AxelAndrews/DocumentationSD/README.md

# DocumentationSD
Documentation hub for the 2024-2025 Portal Box Senior Design project. Contains instruction guides, reports, diagrams, and other documentation related to the project.
