AxelAndrews/DocumentationSD/Diagrams/Other/Work Breakdown Structure.docx

### Work Breakdown Structure

#### 1. Project Management (Axel)

  1.1. Define project scope and requirements
  1.2. Develop and monitor project timeline
  1.3. Coordinate with team members and stakeholders

#### 2. Hardware Design

  2.1. PCB Design & Fabrication (Colton)
    2.1.1. Initial schematic design for ESP32 compatibility
    2.1.2. Layout and routing
    2.1.3. Order PCB fabrication (account for lead time)
  2.2. Enclosure Design (Peter + Aidan)
    2.2.1. Define material and dimensions
    2.2.2. Design for component fitting (PCB, display, RFID module)
    2.2.3. Create a 3D model and prototype (e.g., 3D printing)
  2.3. Power Relay System (Colton)
    2.3.1. Select appropriate relays for 120 VAC switching and USB interlock
    2.3.2. Design wiring for safety and functionality
    2.3.3. Test relay and interlock function with dummy loads
3. Firmware Development
  3.1. ESP32 Firmware Migration (Kevin)
    3.1.1. Analyze and adapt existing Raspberry Pi firmware functions
    3.1.2. Develop ESP32-compatible code for RFID, relays, and LED feedback
    3.1.3. Set up development environment for testing
  3.2. Functional Modules
    3.2.1. RFID Module Integration (Aidan)
      3.2.1.1. Program RFID handling for access control
      3.2.1.2. Test RFID responses with user cards
      3.2.1.3. Improve RFID training flow
    3.2.2. Display & Buttons (Aidan + Peter)
      3.2.2.1. Decide on display type and function
      3.2.2.2. Implement LED and buzzer integration
      3.2.2.3. Develop user interaction logic
    3.2.3. Current Sense IC (Colton)
      3.2.3.1. Integrate current-sensing IC into ESP32
      3.2.3.2. Develop code to monitor and report power output levels
4. Front-End Development
  4.1. Admin Dashboard (Aidan/Kevin/Axel)
    4.1.1. Extract current data and create representations
    4.1.2. Determine additional data to transmit/collect
    4.1.3. Add to Makerportal
  4.2. User Dashboard (Aidan/Kevin/Axel)
    4.2.1. Determine what can be shown
    4.2.2. Extract data and create representations
    4.2.3. Add to Makerportal
  4.3. General Navigation (Aidan/Kevin/Axel)
    4.3.1. Add Nav-Bar
    4.3.2. Get more user feedback
    4.3.3. Add customizable features (sounds, displays, profiles)

#### 5. System Integration & Testing (James)

  5.1. Component Integration (PCB, relays, RFID, display)
  5.2. Firmware and Hardware Testing
    5.2.1. Unit testing for each module (e.g., RFID, display)
    5.2.2. Integration testing with connected components
  5.3. Prototype Assembly and Functional Testing
    5.3.1. Assemble enclosure with internal components
    5.3.2. Run full-system tests for access, power control, and status reporting

Week 1 Milestone (11/13-11/20): PCB initial design review, Enclosure design 3D model, ESP32 environment setup, RFID prototype reading.

Week 2 Milestone (11/21-12/2): PCB sent for fabrication, power relay and interlock wiring draft, firmware for basic functions, RFID test integration.

Week 3 Milestone (12/2-12/9): Begin hardware integration testing, firmware debugging with components, and full-system trial assembly.
