AxelAndrews/DocumentationSD/Diagrams/Flow Diagrams/FlowDiagramV3.pdf

# Does the machine have a usage charge? Does the User have a positive balance?

Turn on equipment power | Was the card removed? | Box in RunningNoCard State Did the equipment exceeds its timeout? Box stays in previous State

No

No

Yes

Box in RunningTimeout State

Yes

Inserts same RFID card

Presses Button

Inserts Proxy card | Box in RunningProxyCard State Was Authorized user a trainer or administrator?

Inserts Unauth card

Inserts unknown card

Box exceeds grace period time

No | Box in RunningTrainingCard State
Yes Was the card removed? | Sends to database indicating authorized use of equipment has ended for user

Yes

Box in RunningAuthUser State

Did user reinsert previous card and push button?

No

Box Returns to Previous State

Yes Box in IdleAuthCard State

Turn Off

Equipment Power Sends to database indicating authorized use of equipment has ended for user Waits until Card is removed

No

Sends to database

indicating unauthorized user of tried to use machine

Sends to database
indicating authorized use of equipment has begun | Restart equipment timeout timer | Turn on equipment power
Yes | Box in RunningAuthUser State

Yes

No | Sends to database indicating authorized use of equipment has begun for user | Restart equipment timeout timer Box in IdleNoCard State | User Inserts RFID card

## and gives PIN

Is user Authorized?

Is user Active?
Yes | Yes Box in IdleUnauthCard State

No

No | No

Turn Off

Equipment Power Sends to database indicating authorized use of equipment has ended for user

Ovals are actions | Dashed border signifies delay Blue Rectangles are Box States (From FSM) Decision or conditional check
Green is database | Red is power | Dark blue is user actions | Black is box action

# Legend
