AxelAndrews/DocumentationSD/Reports/Spring Semester/Spring Team Orginization and Management Report.docx

# Portal Box Team Organization and Management Report

Project Manager: Axel Andrews

Systems & Performance Engineer: James Powick

Design Engineers: Peter Beaudette, Kevin Duong, Aidan Flynn, Colton Jiorle

The spring semester of senior design started off in the middle of phase 4A. While getting back in the swing of things, we began preparing for our unit tests. Each DE had their respective functions for testing and datasheets to write.
