AxelAndrews/DocumentationSD/Diagrams/Other/WBS V2.docx

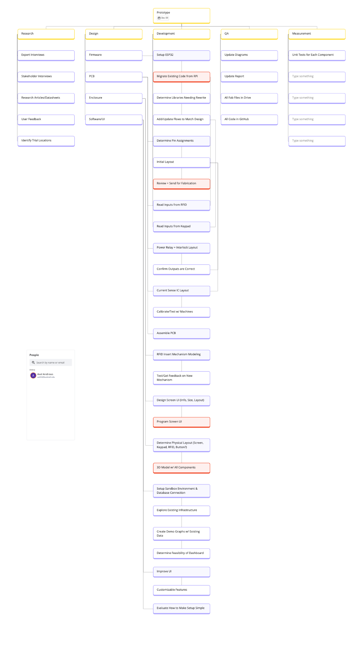
[picture p24: figure]
