AxelAndrews/DocumentationSD/Diagrams/System Maps/SystemMapV1.pdf

System Map (Version 1)

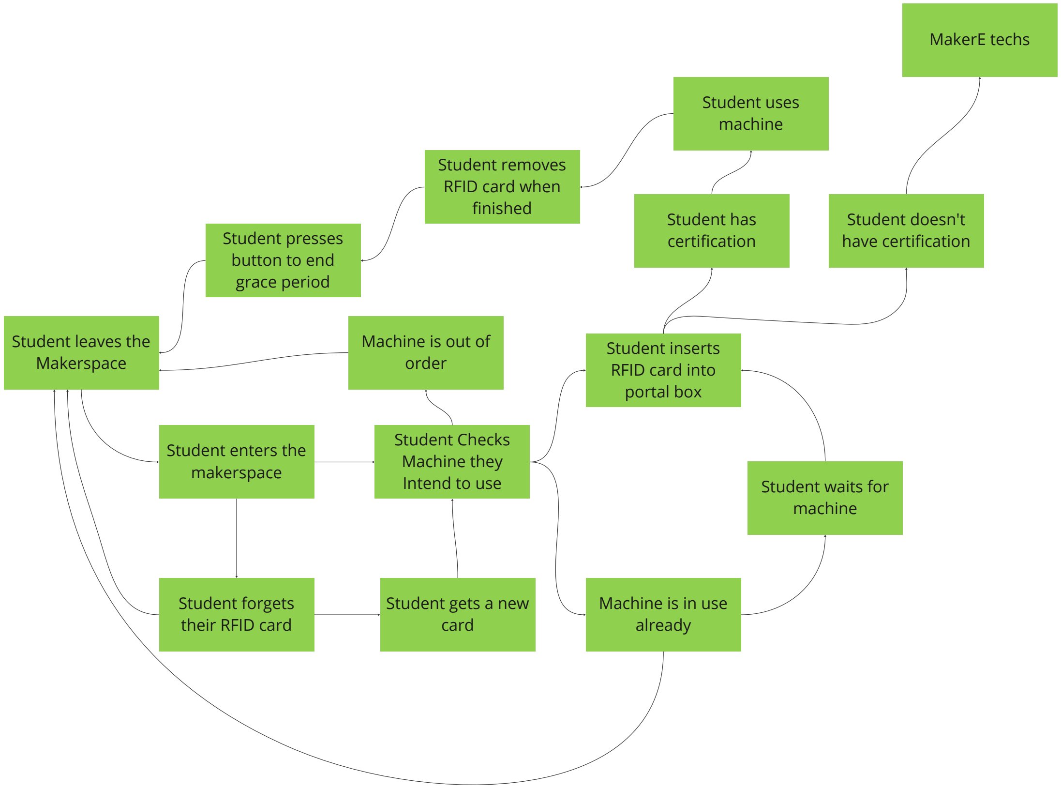
[picture p25: figure]
Student removes RFID card when finished; Machine is out of order; Student presses button to end grace period; Student has certification; Student enters the makerspace; Student leaves the Makerspace; Student waits for machine; Student forgets their RFID card; Student gets a new card; Student inserts RFID card into portal box; Machine is in use already; Student Checks Machine they Intend to use; Student uses machine; Student doesn't have certification; MakerE techs
