AxelAndrews/DocumentationSD/Diagrams/Block Diagrams/L2-V2.pdf

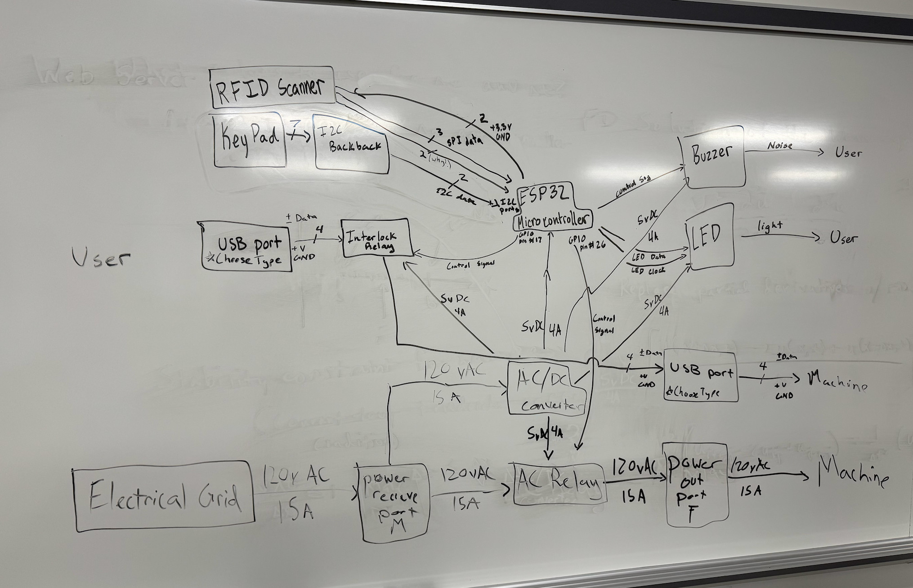
[picture p26: page 1]
