AxelAndrews/DocumentationSD/Fabrication Files/Enclosure/lid_button.SLDPRT

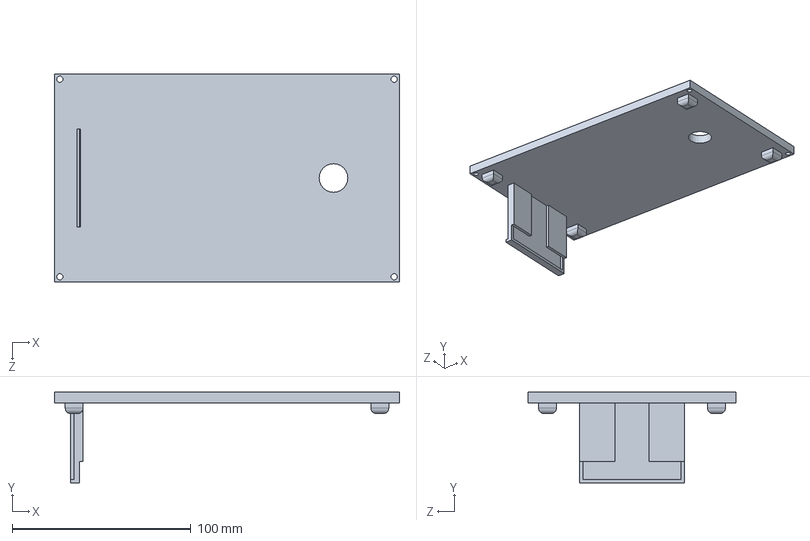
[picture p27: CAD file, 2025-05-12]
Fabrication Files/Enclosure/lid_button.SLDPRT
193.0 x 50.8 x 116.5 mm
