AxelAndrews/DocumentationSD/Fabrication Files/Enclosure/lid_screen_button.SLDPRT

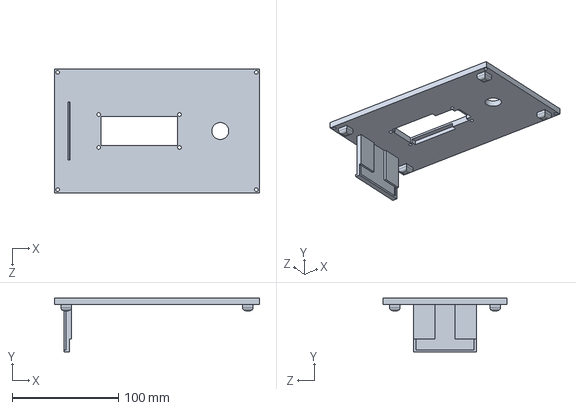
[picture p28: CAD file, 2025-05-12]
Fabrication Files/Enclosure/lid_screen_button.SLDPRT
193.0 x 50.8 x 116.5 mm
