AxelAndrews/DocumentationSD/Fabrication Files/Enclosure/box.SLDPRT

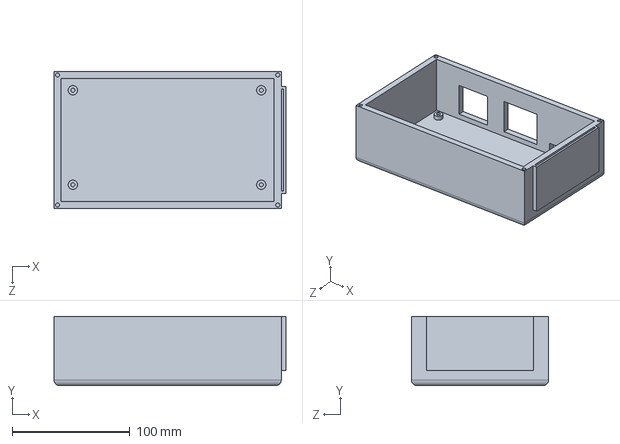
[picture p29: CAD file, 2025-05-12]
Fabrication Files/Enclosure/box.SLDPRT
197.0 x 59.0 x 116.5 mm
