AxelAndrews/DocumentationSD/Fabrication Files/Enclosure/lid.SLDPRT

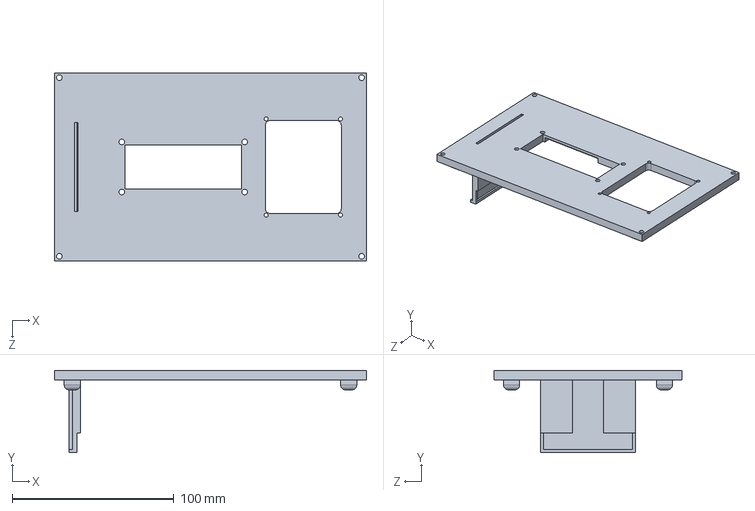
[picture p30: CAD file, 2025-05-12]
Fabrication Files/Enclosure/lid.SLDPRT
193.0 x 50.8 x 116.5 mm
