AxelAndrews/DocumentationSD/Diagrams/Design Abstraction Stacks/DesignAbstractionStackL2.pdf

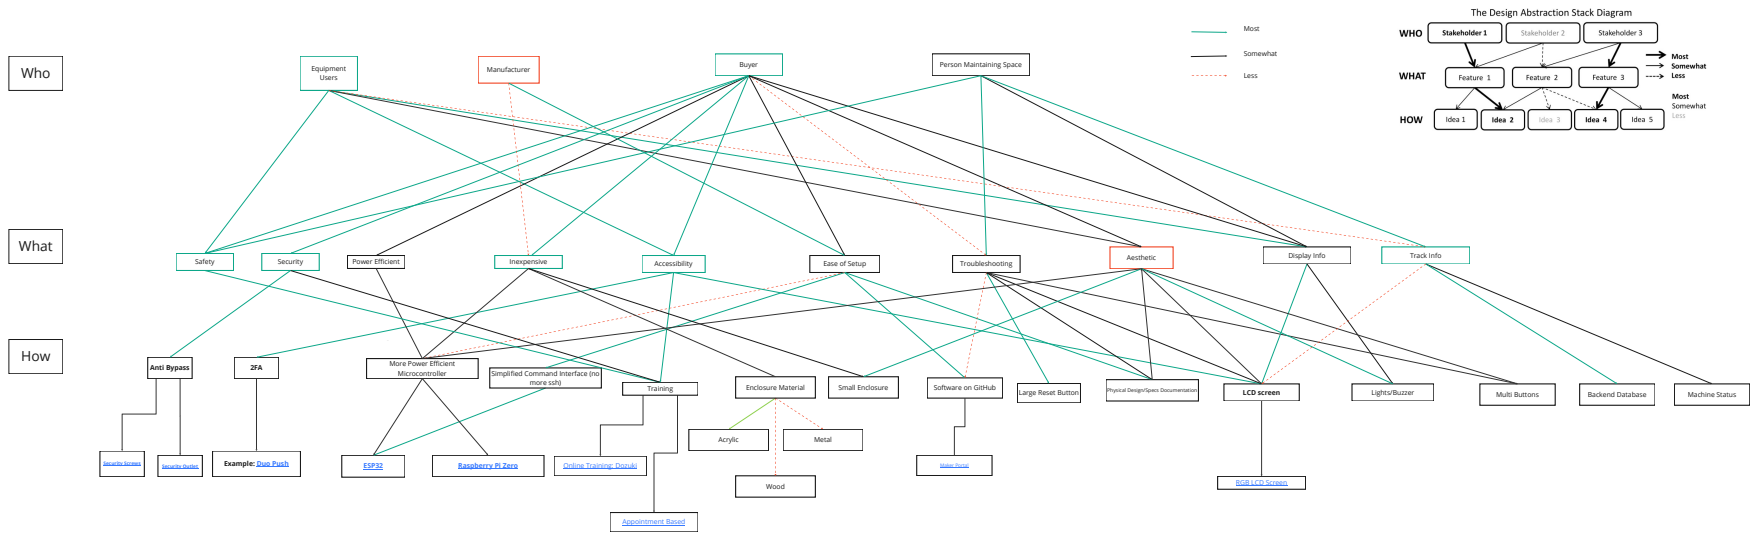
[picture p54: page 1]
ESP32; Wood Acrylic; Metal Raspberry Pi Zero; Online Training: Dozuki; Maker Portal Security Screws; Large Reset Button; Multi Buttons; Backend Database; Machine Status; Security Outlet; Example: Duo Push; Simplified Command Interface (no more ssh); Training; Enclosure Material; Small Enclosure How; Anti Bypass; Physical Design/Specs Documentation; LCD screen; more effi 2FA; More Power Efficient Microcontroller; Lights/Buzzer Software on GitHub Accessibility; Ease of Setup; Troubleshooting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

Less Person Maintaining Space Who

RGB LCD Screen (https://www.adafruit.com/product/398) Appointment Based
