AxelAndrews/DocumentationSD/Diagrams/Block Diagrams/L0-V1.pdf

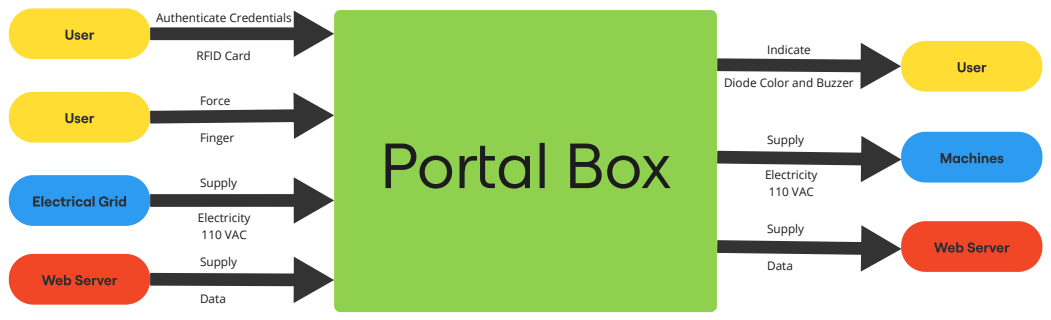
[picture p55: page 1]
Authenticate Credentials; RFID Card; Finger; Force; Electricity 110 VAC; Supply; Data; Indicate

Diode Color and Buzzer
