AxelAndrews/DocumentationSD/Diagrams/Block Diagrams/L1-V2.pdf

# Portal Box Block Diagram L1

# Acrylic Enclosure

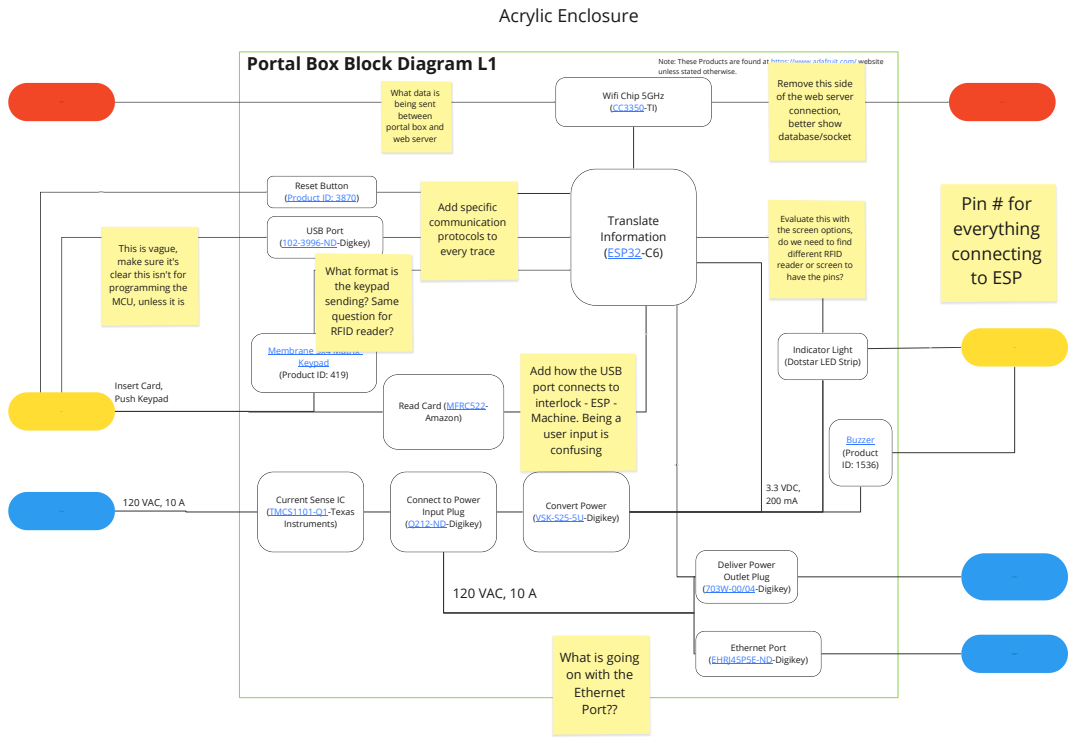
[picture p56: page 1]
User; Electrical Grid; Convert Power (VSK-S25-5U-Digikey); Translate Information (ESP32-C6); Binary 0 or 1; Web Server; 120 VAC, 10 A; Insert Card, Push Keypad; 3.3 VDC, 200 mA; Buzzer (Product ID: 1536); Membrane 3x4 Matrix Keypad (Product ID: 419); Wifi Chip 5GHz (CC3350-TI); Web Server Data; User/Machine Data; Ethernet Port (EHRJ45P5E-ND-Digikey); Deliver Power Outlet Plug (703W-00/04-Digikey); Reset Button (Product ID: 3870); Push Button; Binary 0 or 1 USB Port; (102-3996-ND-Digkey)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

Note: These Products are found at https://www.adafruit.com/ website
unless stated otherwise.

Remove this side
of the web server
connection,
better show
database/socket

What data is
being sent
between
portal box and
web server

Web Server 2.4 or 5GHz

Evaluate this with
the screen options,
do we need to find
different RFID
reader or screen to
have the pins?

User Inputs Keypresses
This is vague,
make sure it's
clear this isn't for
programming the
MCU, unless it is

What format is
the keypad
sending? Same
question for
RFID reader?

Send Binary to
ESP32

User Card Data

Indicator Light
(Dotstar LED Strip)

Add how the USB
port connects to
interlock - ESP -
Machine. Being a
user input is
confusing

Read Card (MFRC522- (https://www.amazon.com/SunFounder-Mifare-Reader-Arduino-Raspberry/dp/B07KGBJ9VG) Amazon)

Signal To Deliver Power to Machines

Current Sense IC
(TMCS1101-Q1-Texas (https://www.ti.com/product/TMCS1101-Q1?ds_k=TMCS1101-Q1&DCM=yes&gad_source=1&gclsrc=aw.ds)
Instruments)

Connect to Power
Input Plug
(Q212-ND-Digikey) (https://www.digikey.com/en/products/detail/qualtek/703W-00-04/245553)

Machines
(Able to be turned off)

What is going
on with the
Ethernet
Port??

Constantly Powered Machines
