AxelAndrews/DocumentationSD/Diagrams/Block Diagrams/L2-V6.pdf

# User

# Buzzer

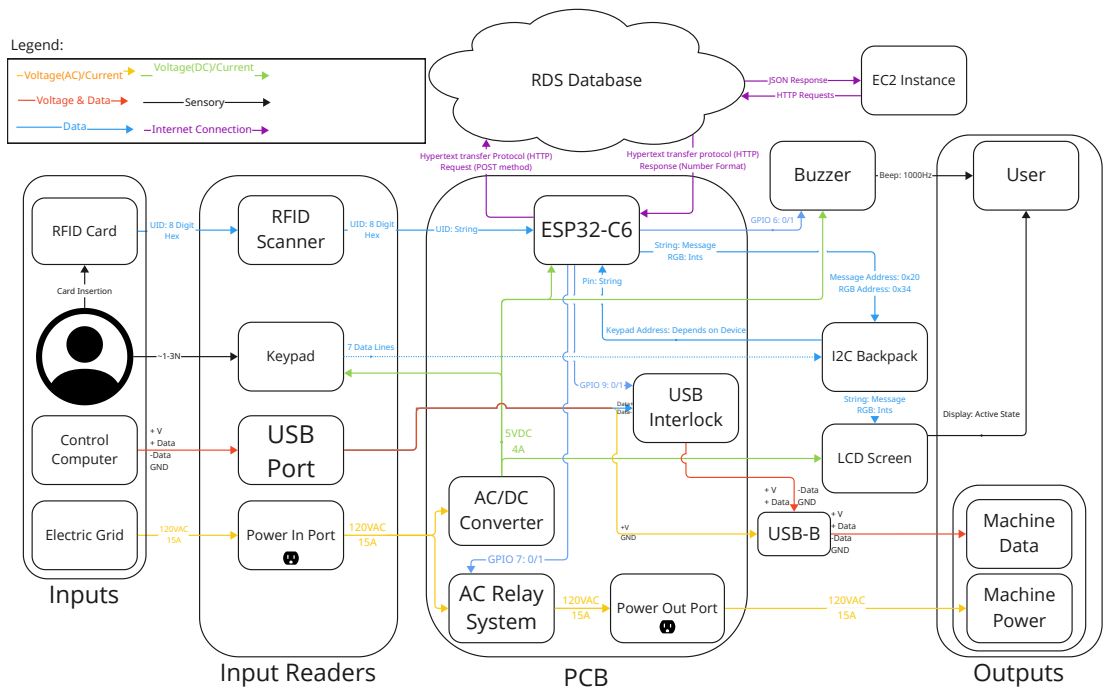
[picture p57: page 1]
ESP32-C6 RFID Scanner; USB Port; Machine Power; Machine Data; AC Relay System; AC/DC Converter; Input Readers; RFID Card; UID: 8 Digit; Hex; LCD Screen; I2C Backpack; PCB; GPIO 6: 0/1; Beep: 1000Hz; 120VAC 15A; UID: 8 Digit Hex; UID: String; 5VDC 4A; Message Address: 0x20 RGB Address: 0x34; String: Message RGB: Ints; Keypad; 7 Data Lines; Pin: String; Outputs; Electric Grid; 120VAC; Card Insertion; Inputs; USB Interlock; GPIO 9: 0/1; USB-B; + V + Data -Data GND; Control Computer; +V GND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

Voltage(DC)/Current

Voltage(AC)/Current
Voltage & Data
Data

Hypertext transfer Protocol (HTTP)
Request (POST method)

Hypertext transfer protocol (HTTP)
Response (Number Format)

Keypad Address: Depends on Device

Display: Active State

Power In Port

120VAC
Power Out Port
