AxelAndrews/DocumentationSD/Diagrams/Use Case Diagrams/UseCaseV2-1.pdf

# Portal Box Use Cases

Scan Card | Standard Users

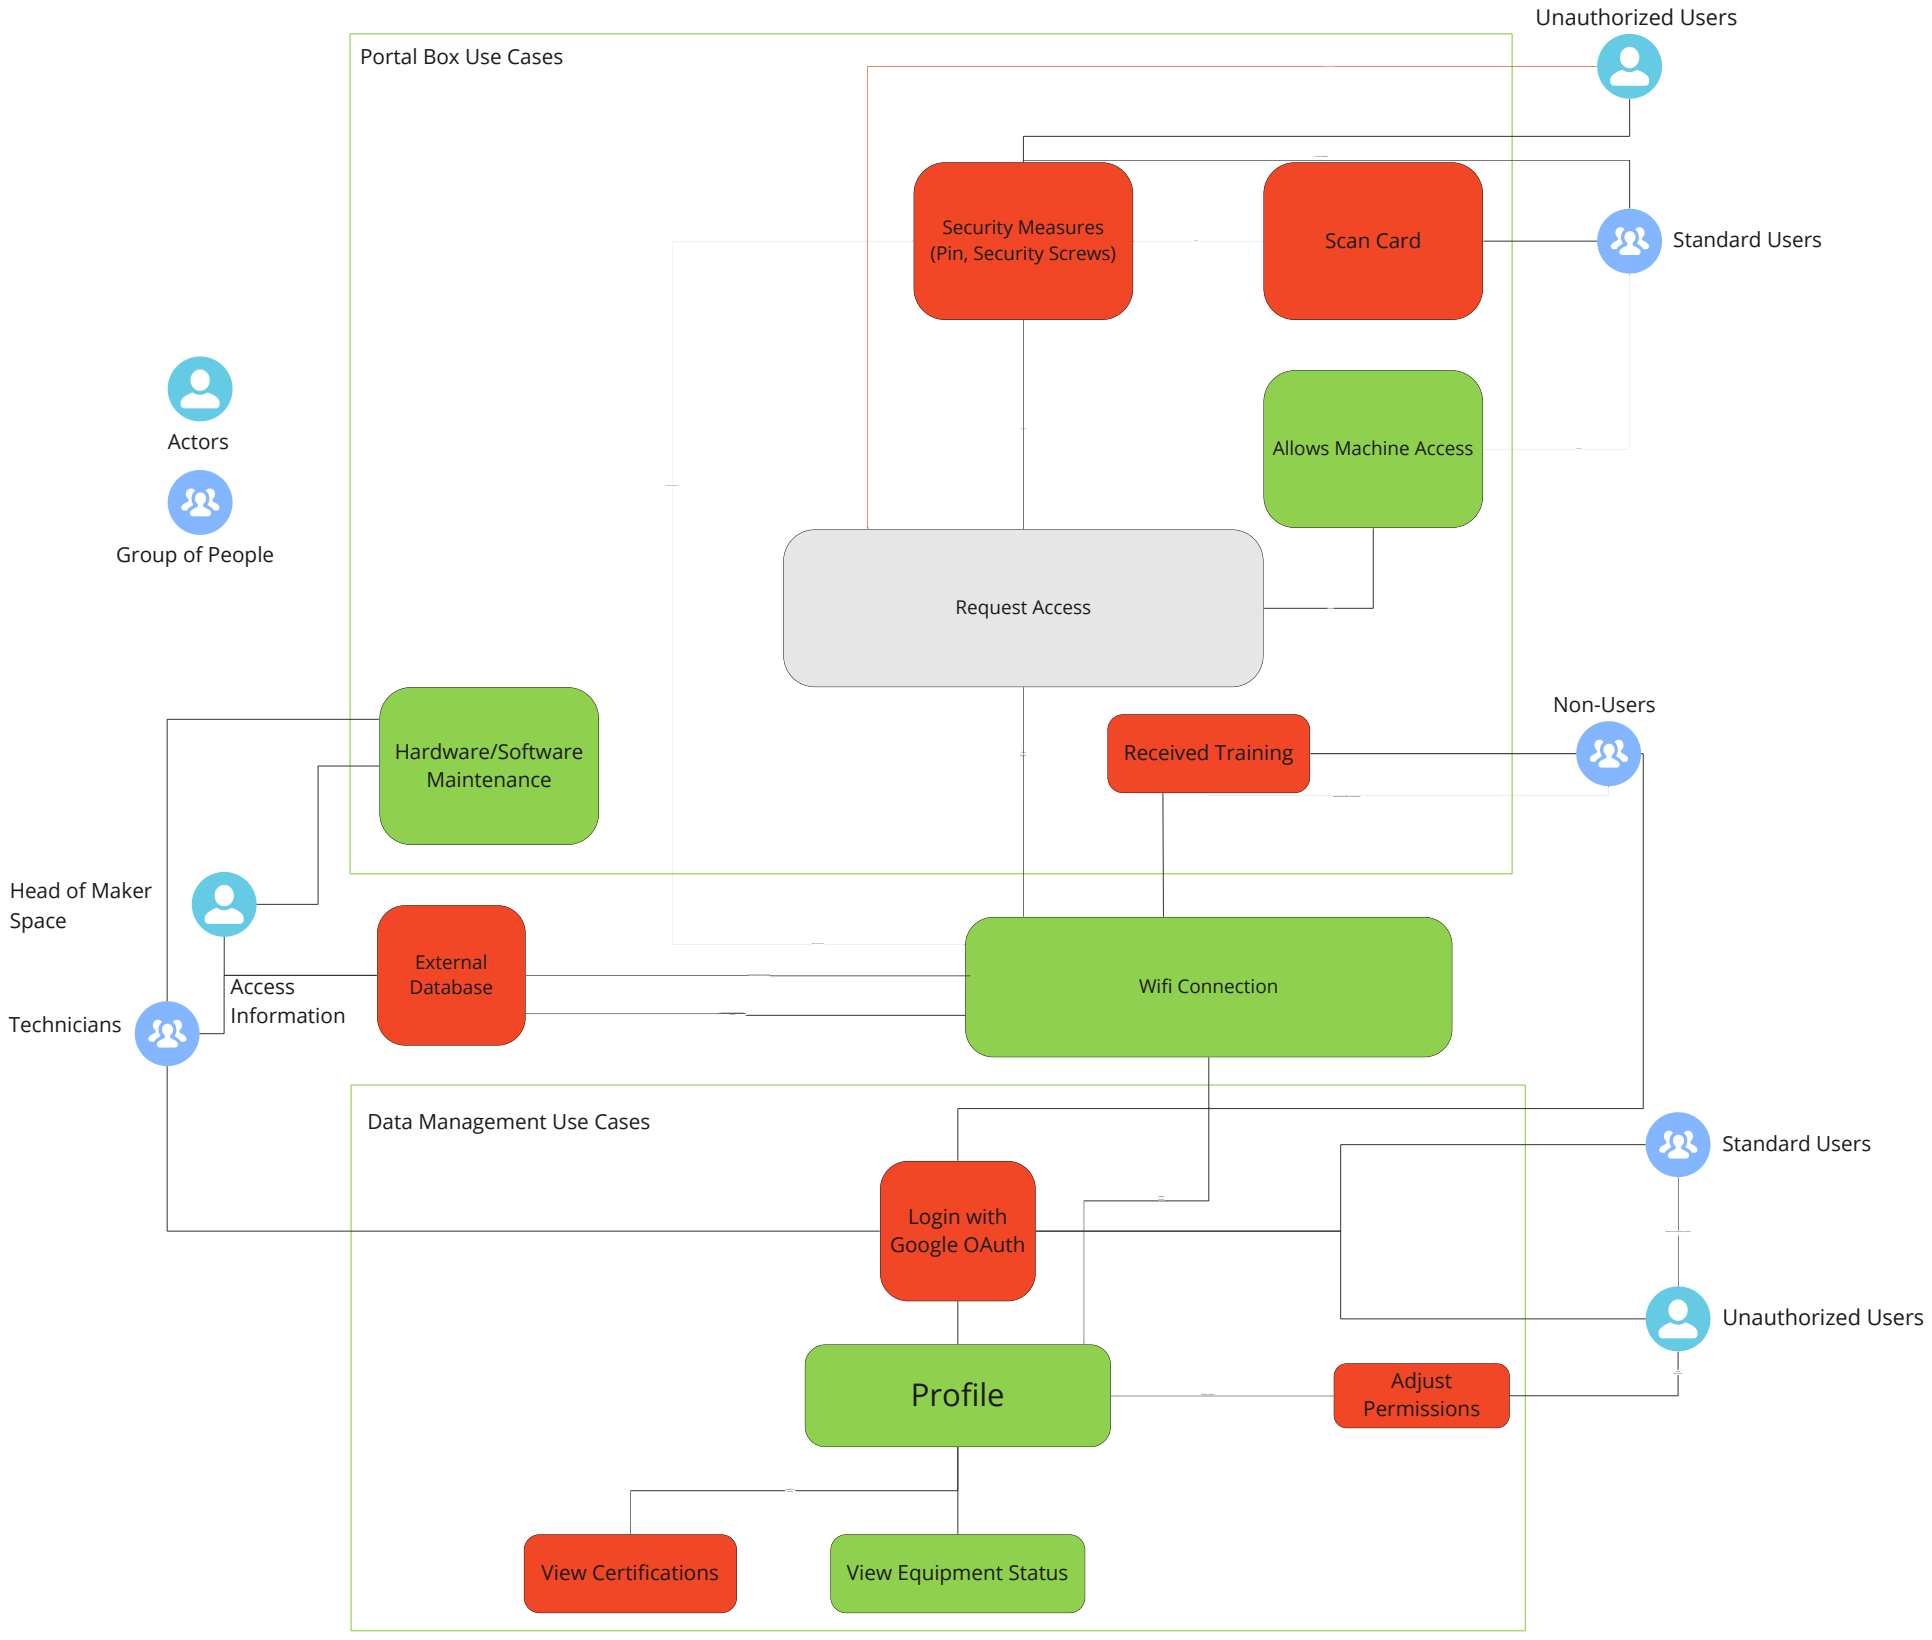
[picture p58: page 1]
Hardware/Software Maintenance; Technicians; Request Access; Wifi Connection; Actors; Allows Machine Access; Use Machine; Include; Unauthorized Users; Confirm Identity; Confirm Information; Extend; Deny Access; Non-Users; Received Training; Standard Users; View Certifications; Adjust Permissions Profile; Available to all users; Update Profile; Login with Google OAuth; External Database; Access Information; Grant Permission; Send Request

Security Measures
(Pin, Security Screws)

Extend, if Pin

Group of People

Receive Permission (if Successful)

Head of Maker
Space

Take User Information from Database

Microcontroller sends information to Database

Data Management Use Cases

Extend; If successfully certified

Extend; if Admin

View Equipment Status
