AxelAndrews/DocumentationSD/Diagrams/Use Case Diagrams/UseCaseV2-3.pdf

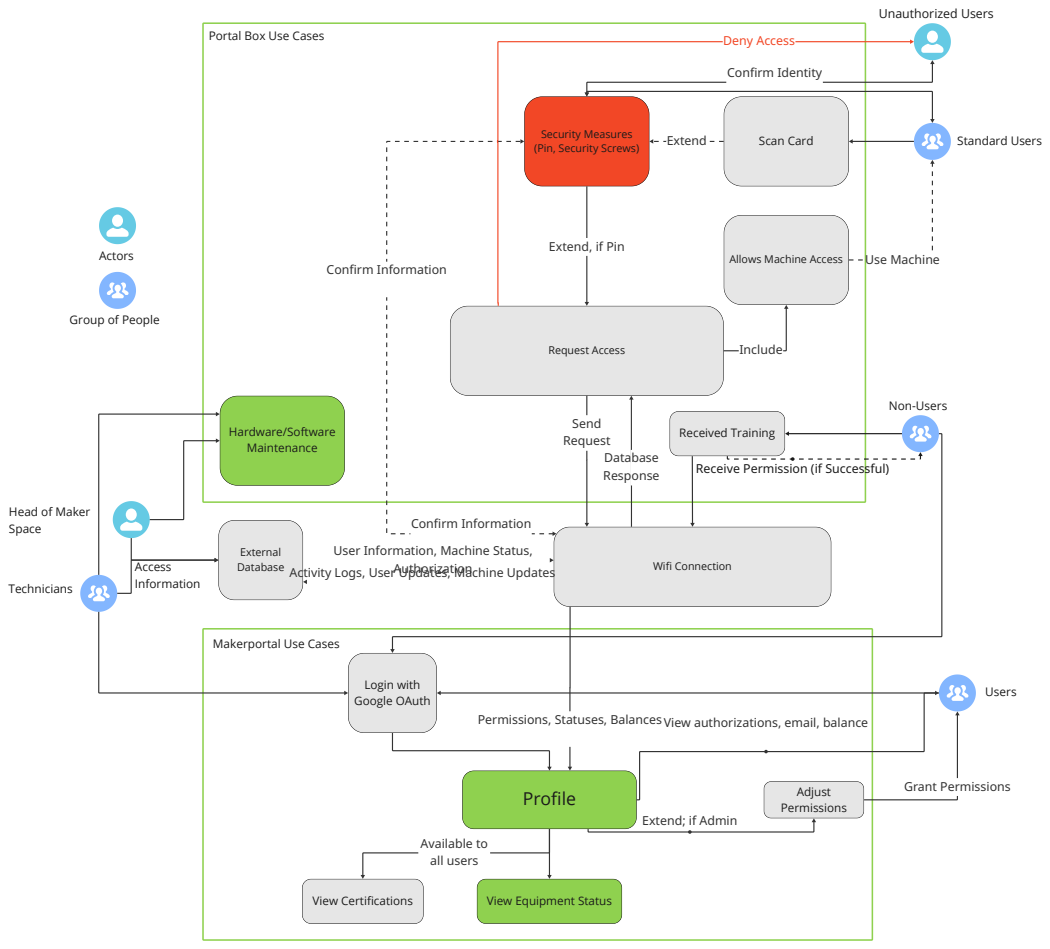
[picture p59: page 1]
Scan Card; Standard Users; Hardware/Software Maintenance; Technicians; Request Access; Wifi Connection; Actors; Allows Machine Access; Use Machine; Include; Unauthorized Users; Confirm Identity; Confirm Information; Extend; Deny Access; Non-Users; Received Training; Users; View Certifications; Adjust Permissions Profile; Available to all users; Login with Google OAuth; Access; Authorization; Information; Grant Permissions; Send Request Database Response

Portal Box Use Cases

Security Measures
(Pin, Security Screws)

Extend, if Pin

Group of People

Receive Permission (if Successful)

Head of Maker
Space

User Information, Machine Status,

External
Database Activity Logs, User Updates, Machine Updates

Makerportal Use Cases

Permissions, Statuses, BalancesView authorizations, email, balance

Extend; if Admin

View Equipment Status
