AxelAndrews/DocumentationSD/Diagrams/Flow Diagrams/MakerportalFlowDiagram.pdf

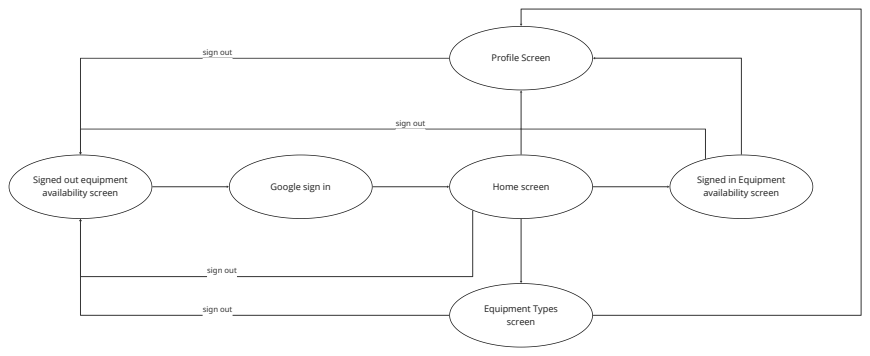
[picture p60: page 1]
availability screen; Google sign in; Home screen; Equipment Types screen; Profile Screen; sign out

Signed out equipment

Signed in Equipment
availability screen
