AxelAndrews/DocumentationSD/Diagrams/System Maps/Community&UserValueLoop.pdf

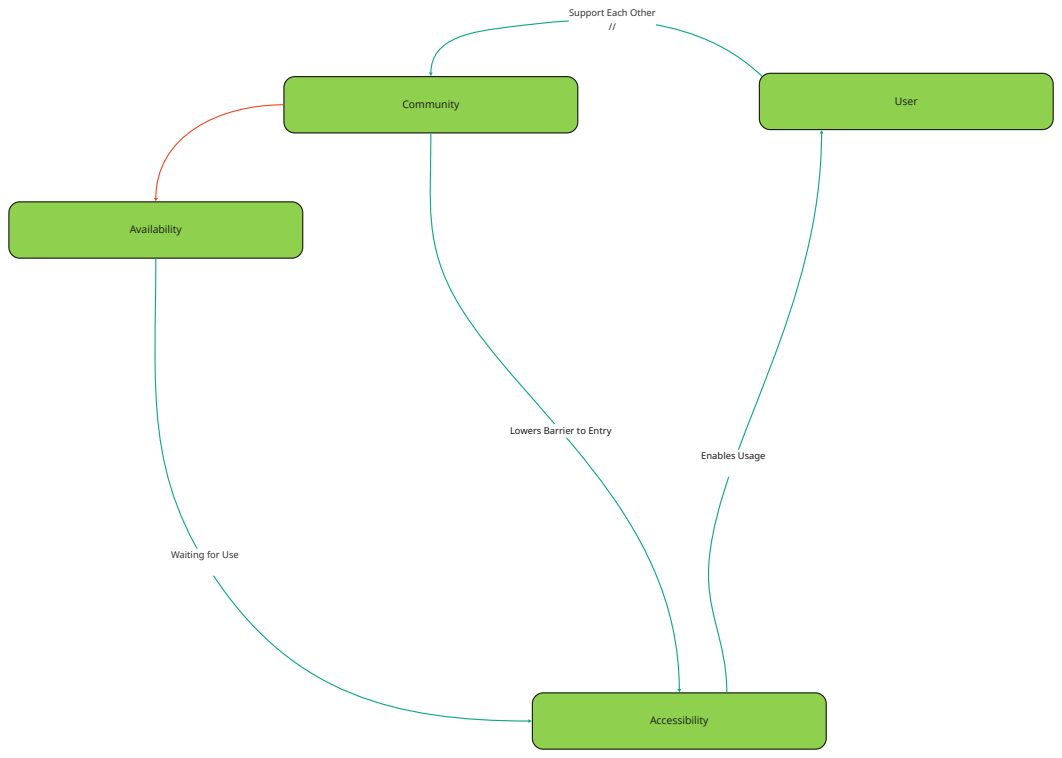
[picture p61: page 1]
Accessibility; User; Enables Usage; Community; Availability

Support Each Other

Lowers Barrier to Entry

Waiting for Use
