AxelAndrews/DocumentationSD/Diagrams/System Maps/DirectorValueLoop.pdf

## Director of Space

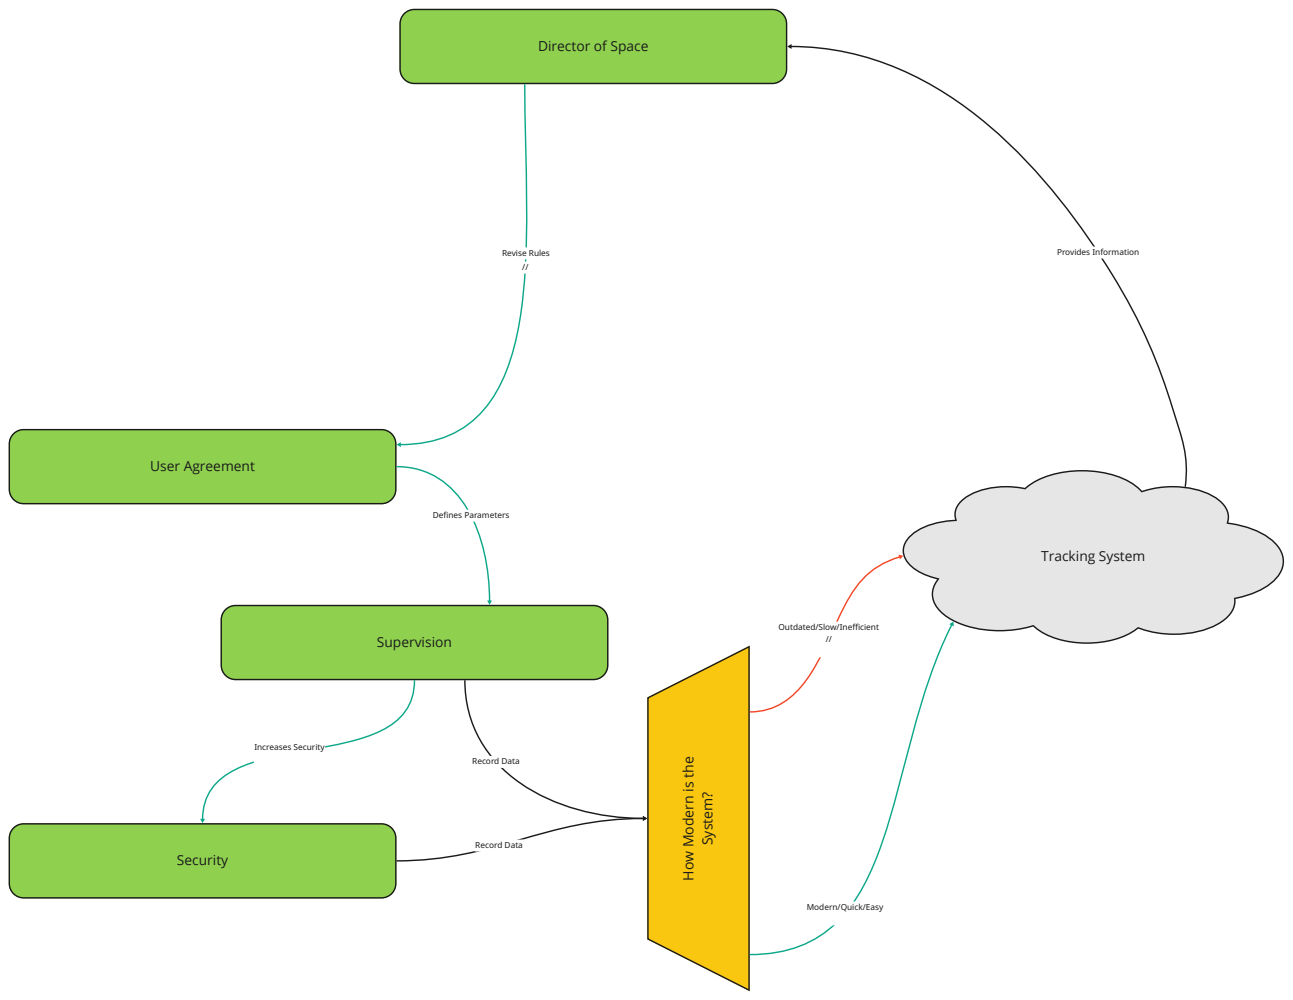
[picture p62: page 1]
Security; Record Data; Supervision; Increases Security; User Agreement; Defines Parameters; Revise Rules //; Tracking System; Provides Information

Outdated/Slow/Inefficient

How Modern is the System?

Modern/Quick/Easy
