AxelAndrews/DocumentationSD/Diagrams/System Maps/FinalSecurityVsAccessibilityLoop.pdf

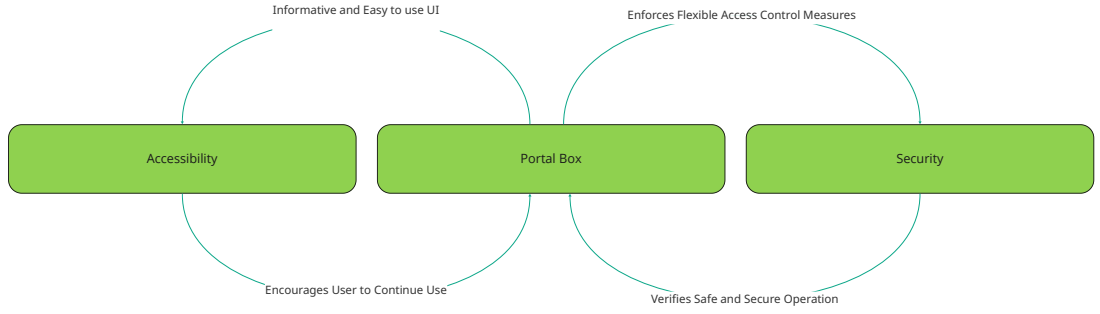
[picture p63: page 1]
Accessibility; Portal Box; Security

Informative and Easy to use UI

Enforces Flexible Access Control Measures

Encourages User to Continue Use

Verifies Safe and Secure Operation
