AxelAndrews/DocumentationSD/Diagrams/System Maps/ImprovedSecurityVsAccessibilityLoop.pdf

## Portal Box

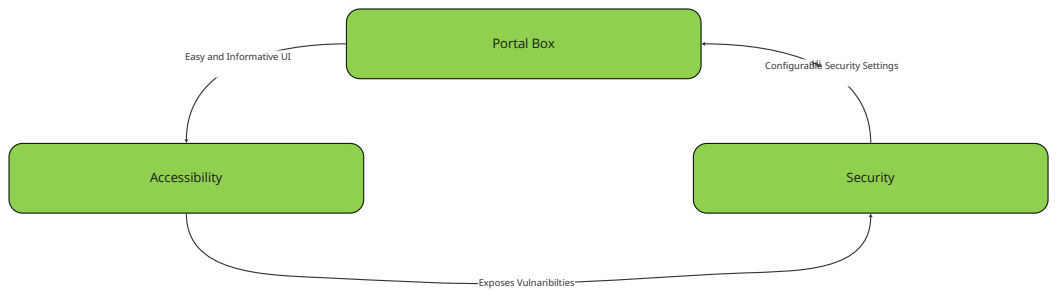
[picture p64: page 1]
Accessibility; Security; ConfigurabHi; Exposes Vulnaribilties

Easy and Informative UI

le Security Settings
