AxelAndrews/DocumentationSD/Diagrams/System Maps/SystemMapV8.pdf

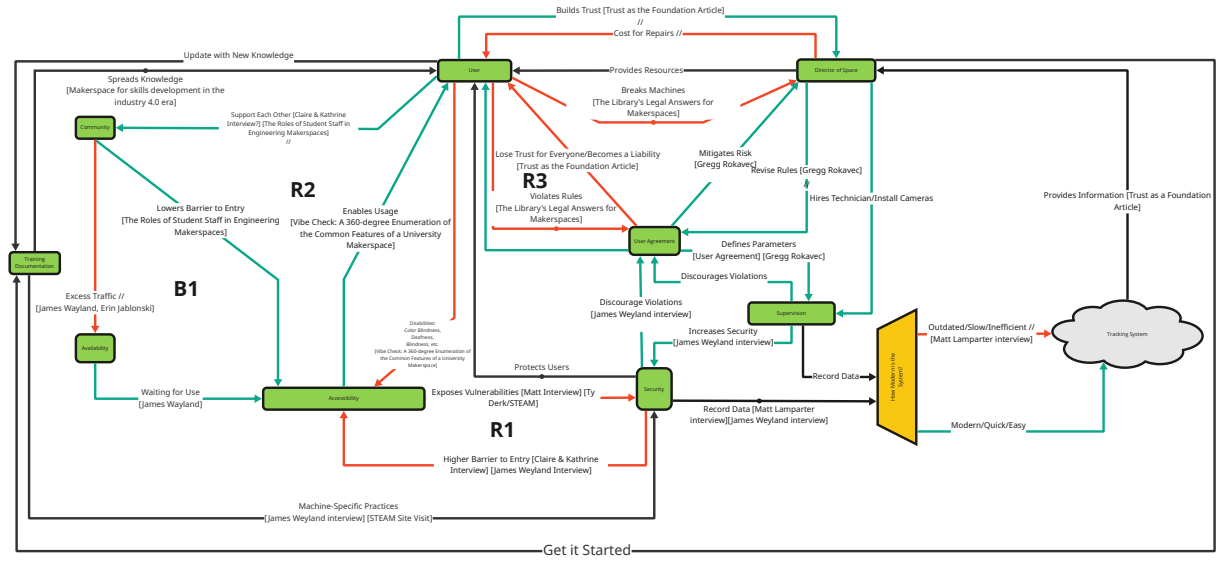
[picture p65: page 1]
User; Director of Space; Makerspaces]; User Agreement; Mitigates Risk [Gregg Rokavec]; Violates Rules; Supervision; Tracking System; Security; Protects Users; Article]; Discourages Violations; How Modern is the System?; Record Data; interview][James Weyland interview]; Modern/Quick/Easy; Training Documentation; Spreads Knowledge; industry 4.0 era]; Accessibility; Derk/STEAM]; Community; Enables Usage; Makerspace]; Availability; Blindness, etc.

Builds Trust [Trust as the Foundation Article]

Cost for Repairs //

Update with New Knowledge

Provides Resources
Breaks Machines
[The Library's Legal Answers for

[Makerspace for skills development in the

Support Each Other [Claire & Kathrine
Interview?] [The Roles of Student Staff in
Engineering Makerspaces]

Lose Trust for Everyone/Becomes a Liability
[Trust as the Foundation Article]

Revise Rules [Gregg Rokavec]

Hires Technician/Install Cameras

Provides Information [Trust as a Foundation

Lowers Barrier to Entry

[The Roles of Student Staff in Engineering

[Vibe Check: A 360-degree Enumeration of
the Common Features of a University

Defines Parameters
[User Agreement] [Gregg Rokavec]

Excess Traffic //
[James Wayland, Erin Jablonski]

Discourage Violations
[James Weyland interview]

Disabilities:
Color Blindness, Deafness,

Outdated/Slow/Inefficient //
[Matt Lamparter interview]

Increases Security

the Common Features of a University Makerspace]

Waiting for Use
[James Wayland]

Exposes Vulnerabilities [Matt Interview] [Ty

Record Data [Matt Lamparter

Higher Barrier to Entry [Claire & Kathrine
Interview] [James Weyland Interview]

Machine-Specific Practices

[James Weyland interview] [STEAM Site Visit]

Get it Started
