AxelAndrews/DocumentationSD/Diagrams/System Maps/User&DirectorValueLoop.pdf

User | Director of Space

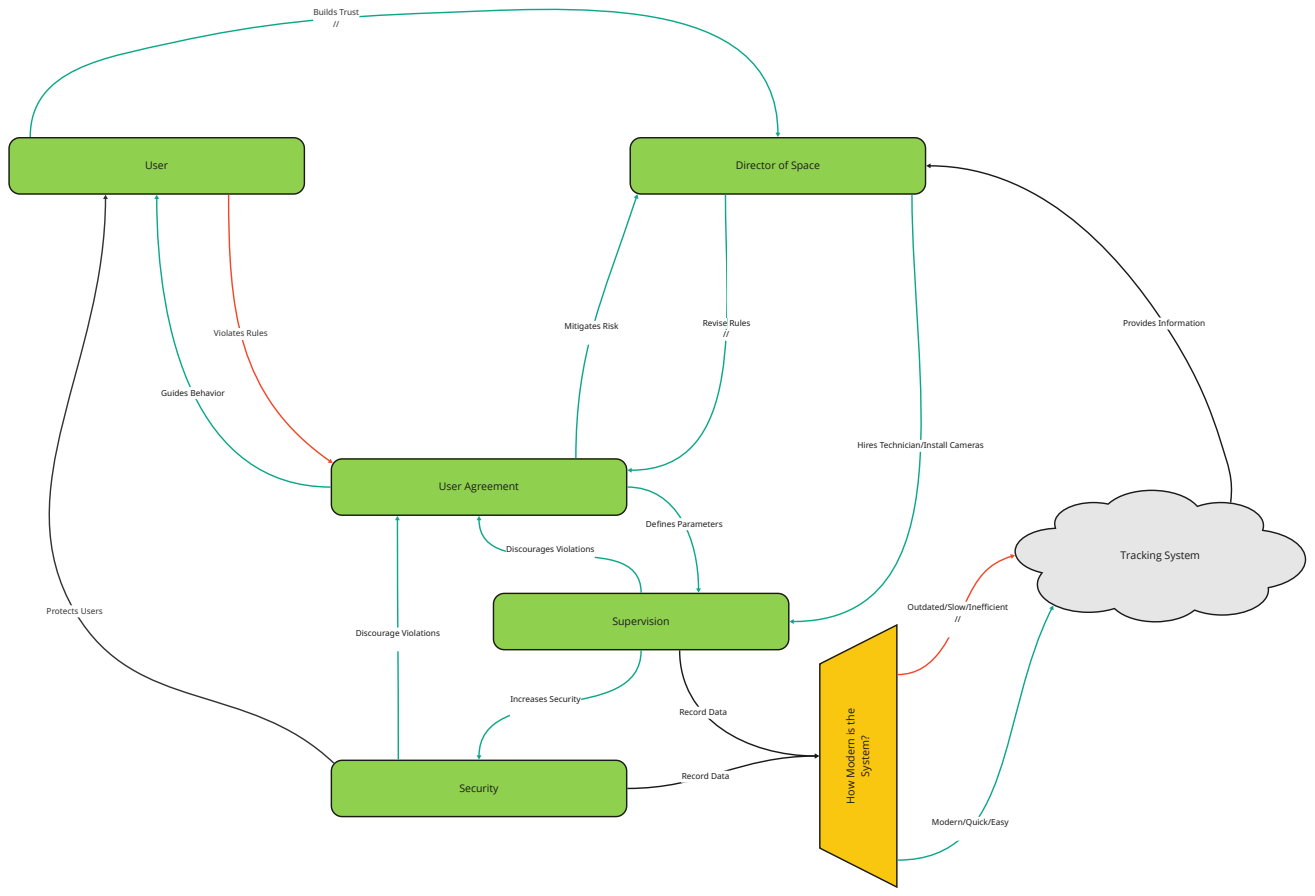
[picture p66: page 1]
Builds Trust //; Security; Supervision; Increases Security; User Agreement; Violates Rules; Guides Behavior; Discourages Violations; Defines Parameters; Discourage Violations; Revise Rules //; Mitigates Risk; Protects Users; How Modern is the System?; Record Data; Tracking System; Provides Information

Hires Technician/Install Cameras

Outdated/Slow/Inefficient

Modern/Quick/Easy
