AxelAndrews/DocumentationSD/Diagrams/Use Case Diagrams/UseCaseV1.pdf

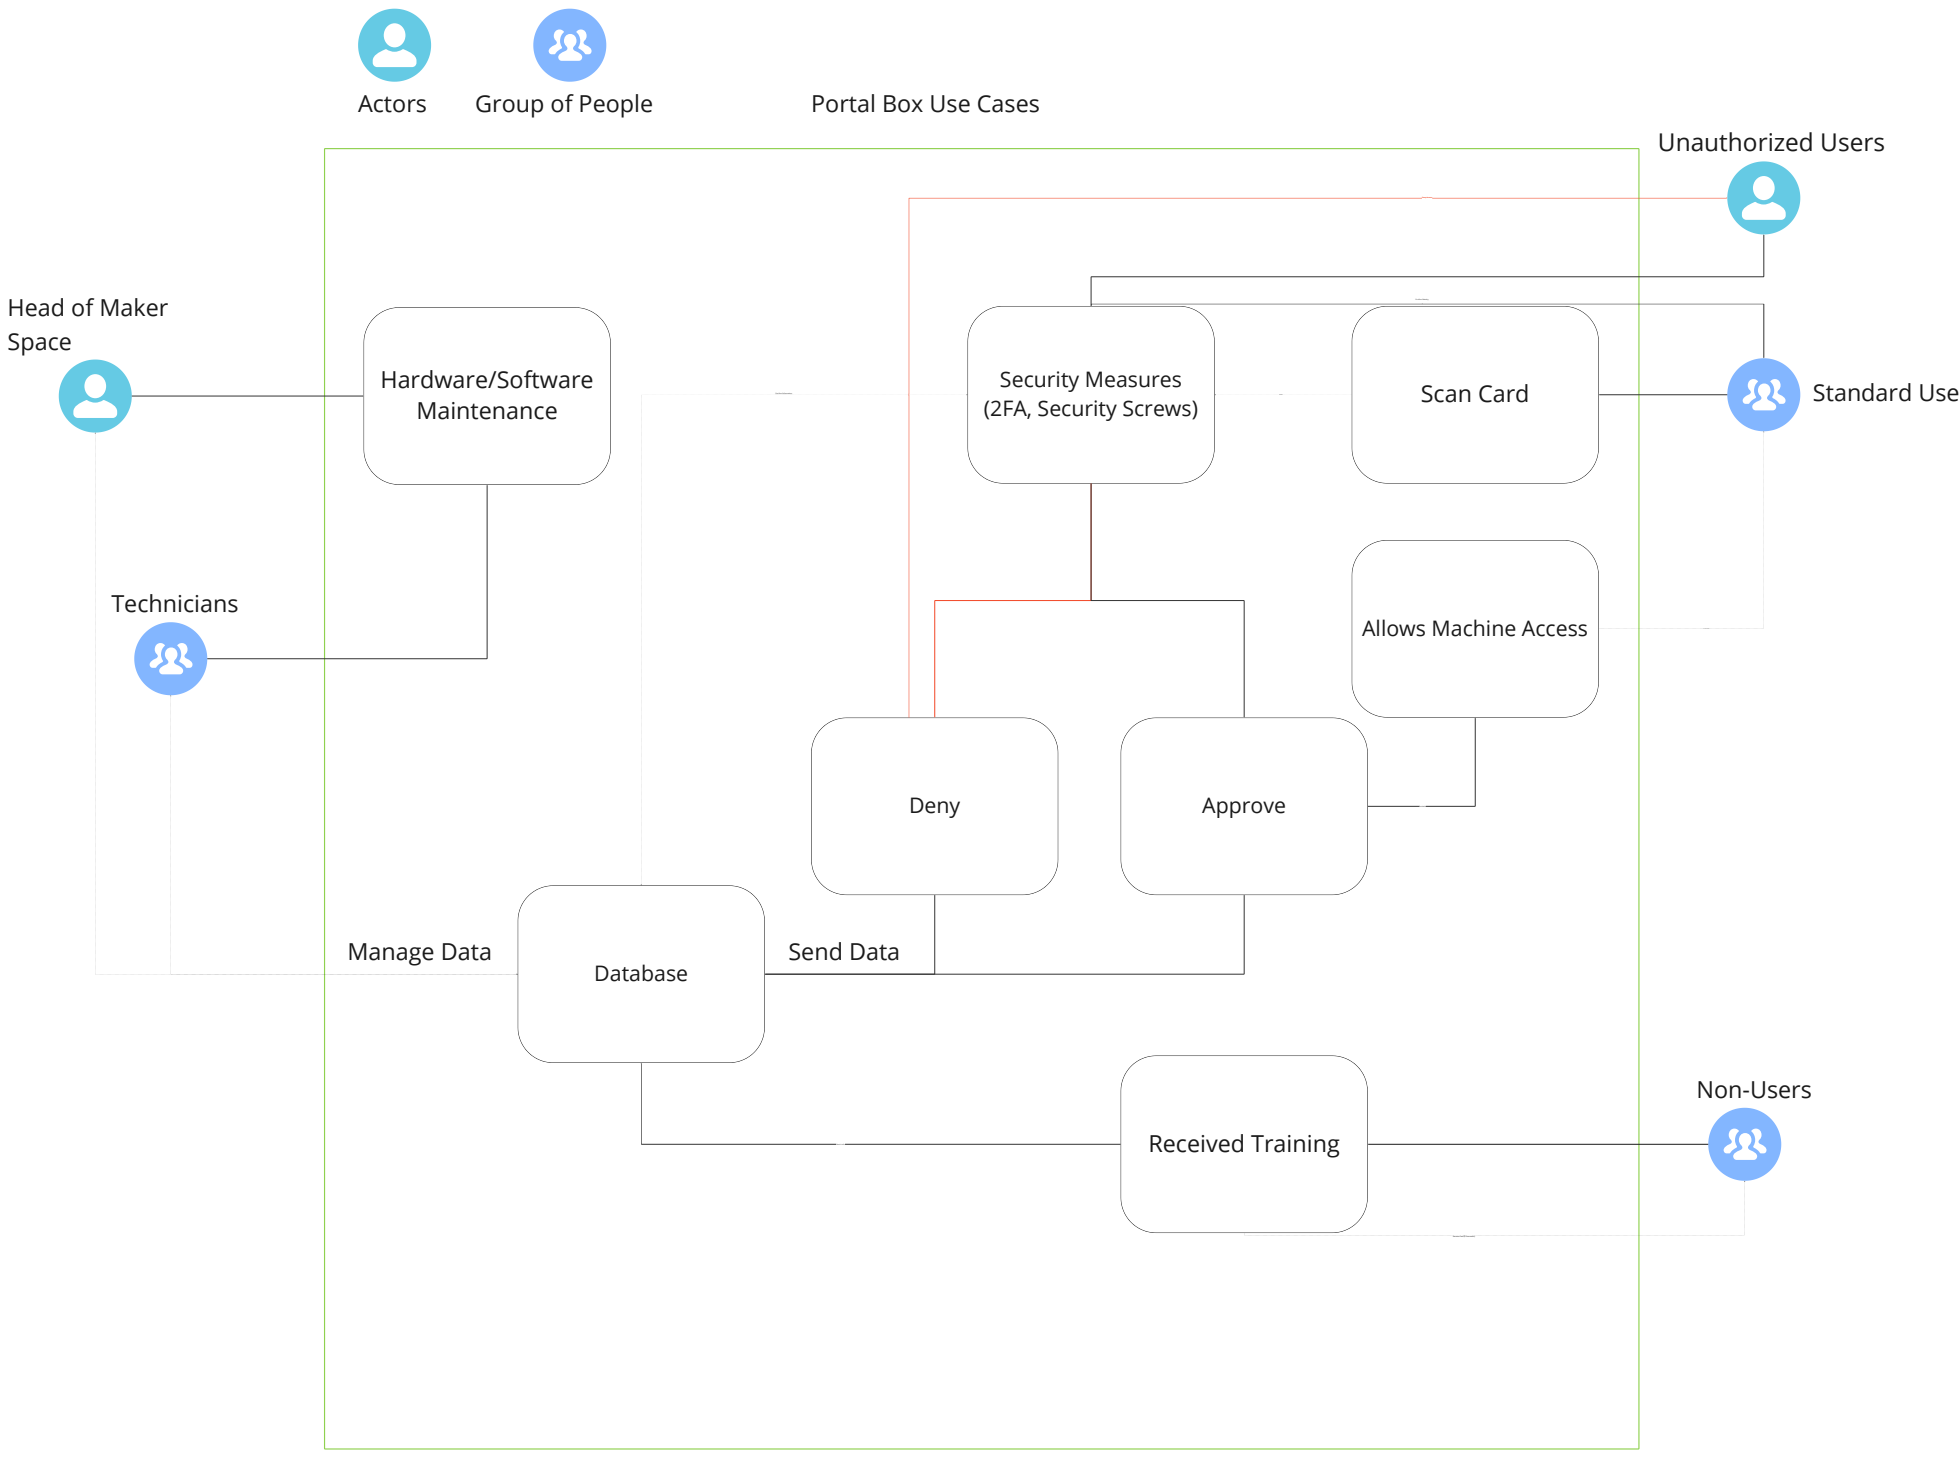
[picture p67: page 1]
Scan Card; Standard Use; Hardware/Software Maintenance; Technicians; Deny; Approve; Database; Send Data; Actors; Use Machine; Include; Unauthorized Users; Security Measures (2FA, Security Screws); Confirm Identity; Confirm Information; Extend; Deny Access; Manage Data; Non-Users

Group of People

Portal Box Use Cases

Head of Maker
Space

Allows Machine Access

Received Training User's info

Receive Card (if Successful)
