AxelAndrews/DocumentationSD/Diagrams/Use Case Diagrams/UseCaseV2-2.pdf

# Portal Box Use Cases

Scan Card | Standard Users

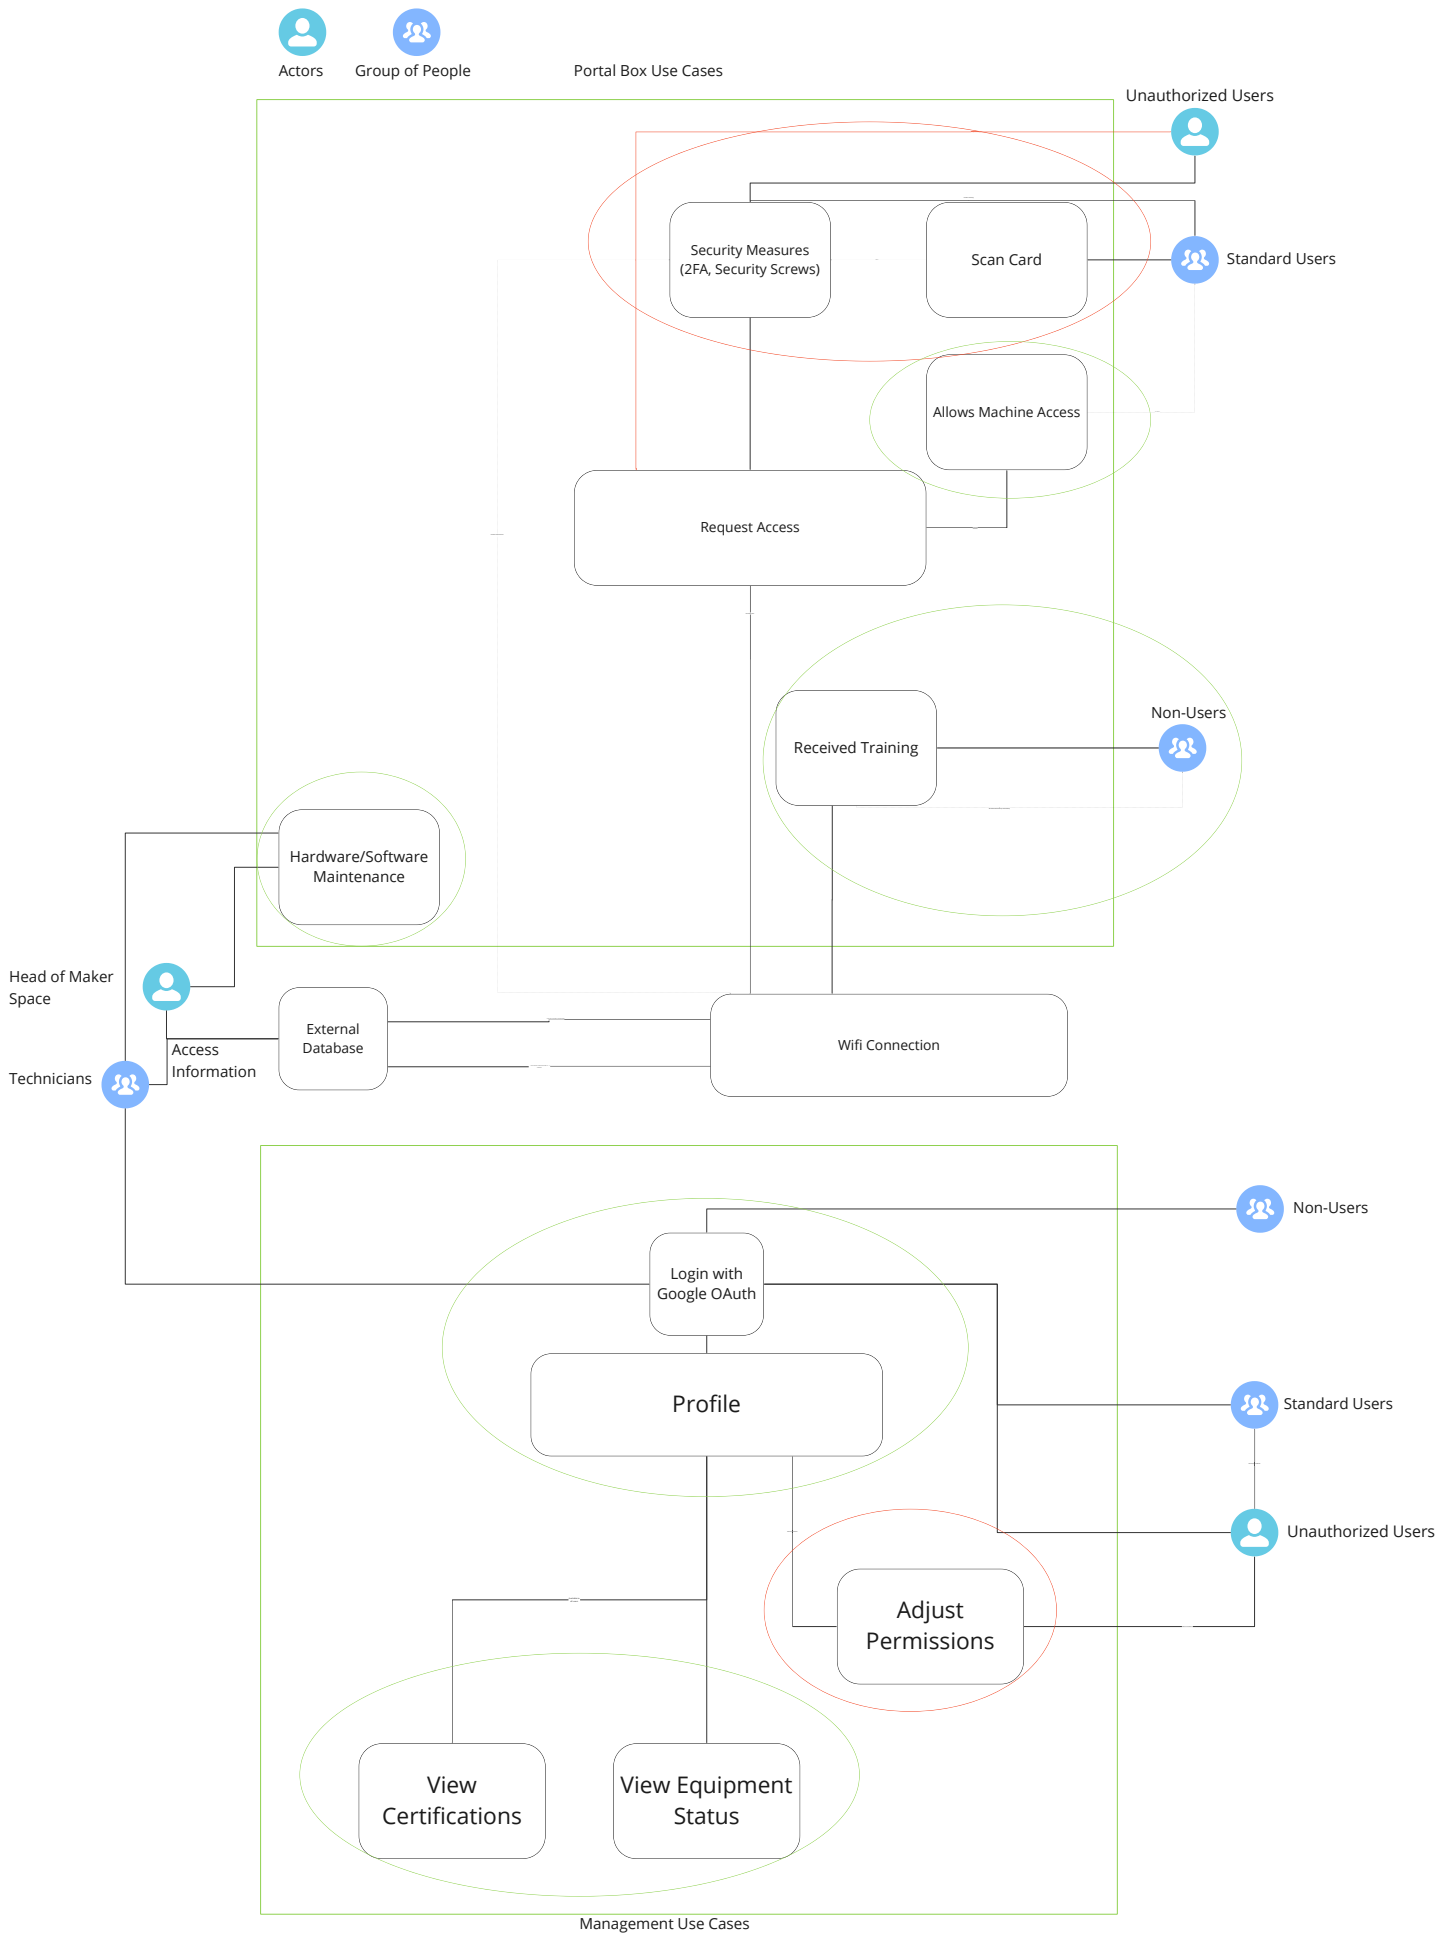
[picture p68: page 1]
Hardware/Software Maintenance; Technicians; Request Access; Wifi Connection; Send Request; Actors; Allows Machine Access; Use Machine; Include; Unauthorized Users; Security Measures (2FA, Security Screws); Confirm Identity; Confirm Information; Extend; Deny Access; Standard Users; Non-Users; View Certifications; Adjust Permissions; Profile; View Equipment Status; Login with Google OAuth; Available to all users; External Database; Access Information; Grant Permission

Group of People

Non-Users Received Training

Receive Permission (if Successful)

Head of Maker
Space

Take User Information from Database

Microcontroller sends information to Database

Extend; If certified

Extend; if Admin

Management Use Cases
