AxelAndrews/DocumentationSD/Diagrams/Block Diagrams/L2-V1.pdf

# Portal Box Block Diagram L2

# Acrylic Enclosure

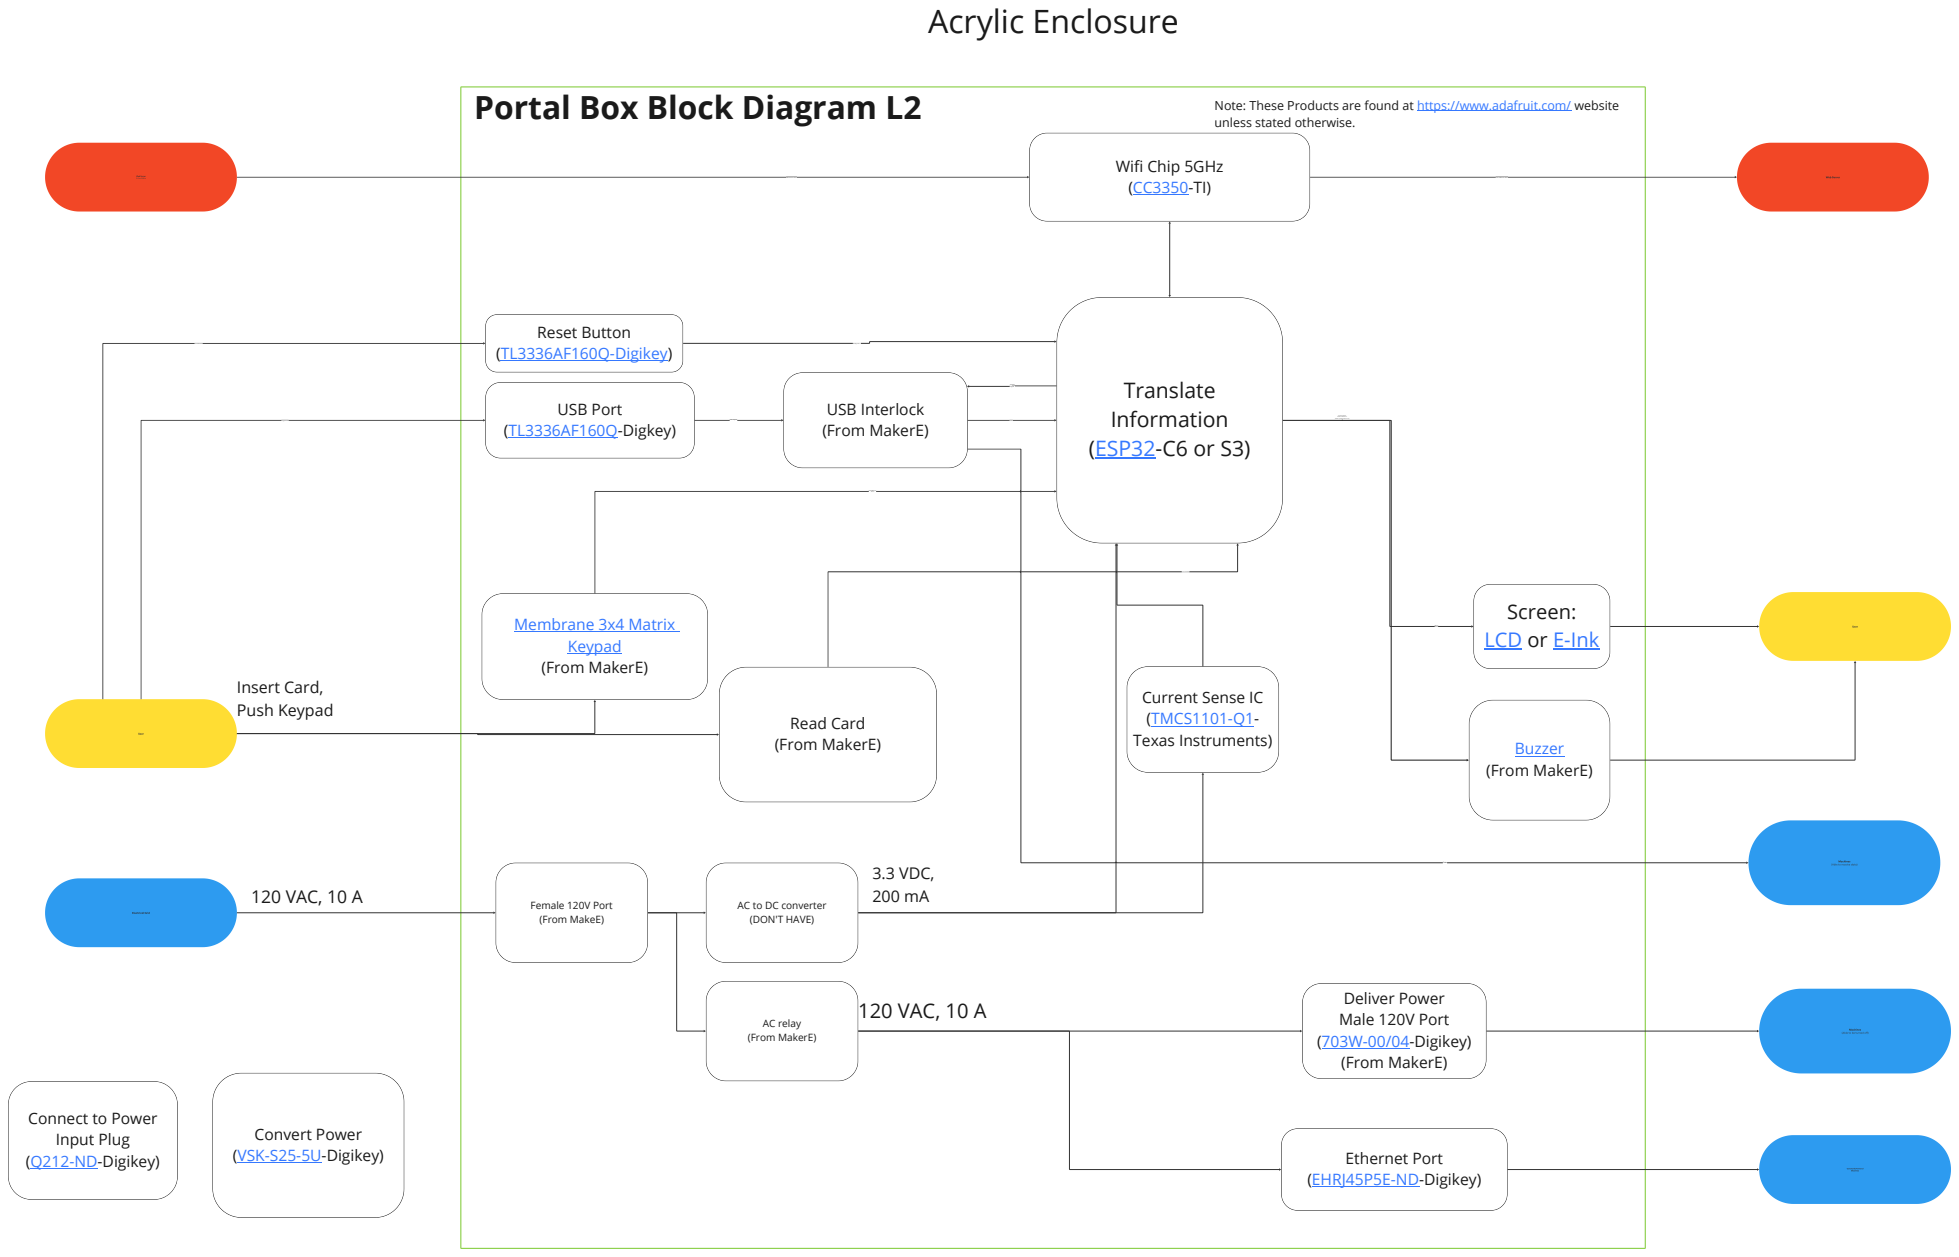
[picture p69: page 1]
User; Electrical Grid; Read Card (From MakerE); Translate Information (ESP32-C6 or S3); Web Server; 120 VAC, 10 A; Insert Card, Push Keypad; 3.3 VDC, 200 mA; Buzzer (From MakerE); Membrane 3x4 Matrix Keypad (From MakerE); Wifi Chip 5GHz (CC3350-TI); Web Server Data; User/Machine Data; Ethernet Port (EHRJ45P5E-ND-Digikey); Deliver Power Male 120V Port (703W-00/04-Digikey) (From MakerE); Machines; Reset Button (TL3336AF160Q-Digikey); Push Button; Binary 0 or 1 USB Port; (TL3336AF160Q-Digkey)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

Note: These Products are found at https://www.adafruit.com/ website
unless stated otherwise.

Web Server 2.4 or 5GHz

Signal To Deliver Power to Machines
(If Box is powered and in Use)

Send Binary to
ESP32

User Card Data

Screen:
LCD (https://www.adafruit.com/product/398) or E-Ink (https://www.adafruit.com/product/4778)

Current Sense IC
(TMCS1101-Q1- (https://www.ti.com/product/TMCS1101-Q1?ds_k=TMCS1101-Q1&DCM=yes&gad_source=1&gclsrc=aw.ds) Texas Instruments)

(Able to receive data) Data

AC to DC converter
(DON'T HAVE)

(Able to be turned off)

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

Constantly Powered Machines
