AxelAndrews/DocumentationSD/Diagrams/Block Diagrams/L2-V3.pdf

# User

SPI | User RFID

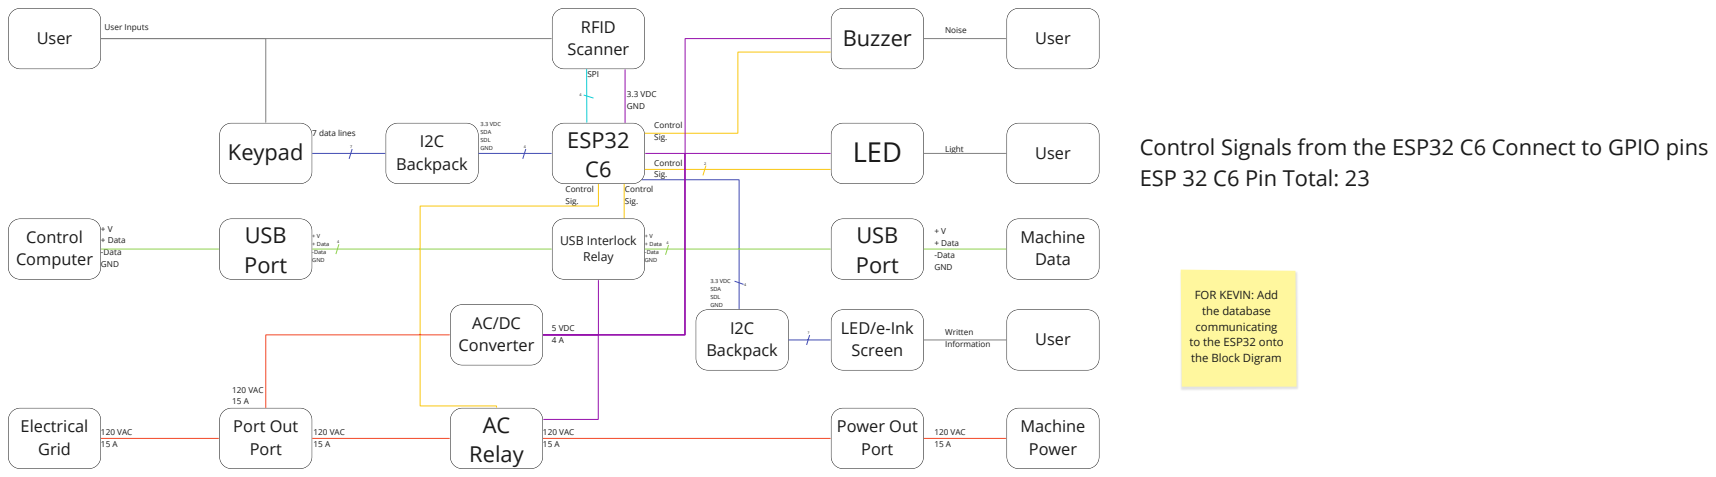
[picture p70: page 1]
User Inputs; + V + Data -Data; GND Control Computer; 120 VAC; 15 A Electrical Grid; Port Out Port; AC Relay; Noise; Light; + V + Data -Data GND; Written Information; Machine; Power; Power Out Port; 3.3 VDC SDA SDL GND I2C Backpack; 7 data lines; Control Sig.; Keypad; ESP32; USB Interlock Relay; 3.3 VDC SDA SDL GND; 3.3 VDC GND; 5 VDC 4 A; 120 VAC 15 A; USB Port; AC/DC Converter; LED; LED/e-Ink Screen; User; Machine Data; Backpack; Scanner; Buzzer

Control Signals from the ESP32 C6 Connect to GPIO pins
ESP 32 C6 Pin Total: 23

FOR KEVIN: Add
the database
communicating
to the ESP32 onto
the Block Digram
