AxelAndrews/DocumentationSD/Diagrams/Block Diagrams/L2-V4.pdf

# Database

## 120V AC Power

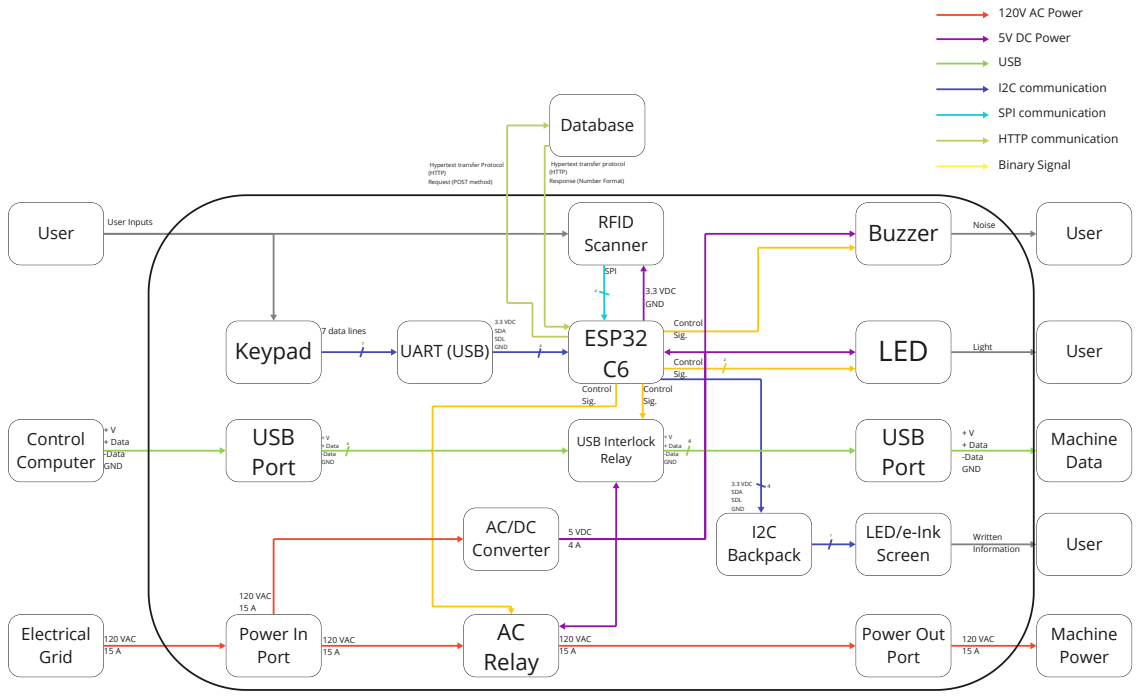
[picture p71: page 1]
User Inputs; + V + Data -Data GND; Control Computer; User; 120 VAC 15 A; Electrical Grid; Power In Port; AC Relay; Noise; Light; Written Information; Machine Power; Power Out Port; 3.3 VDC SDA SDL; 7 data lines; Control Sig.; Keypad; ESP32; USB Interlock Relay; 3.3 VDC SDA SDL GND; 3.3 VDC GND; 5 VDC 4 A; USB Port; AC/DC Converter; LED; LED/e-Ink Screen; Machine Data; I2C Backpack; SPI; Scanner; Buzzer; 5V DC Power; USB; I2C communication; SPI communication; HTTP communication; Binary Signal

Hypertext transfer Protocol
(HTTP)
Request (POST method)

Hypertext transfer protocol
Response (Number Format)
User RFID

GND UART (USB)
