AxelAndrews/DocumentationSD/Diagrams/Flow Diagrams/FlowDiagramV1.pdf

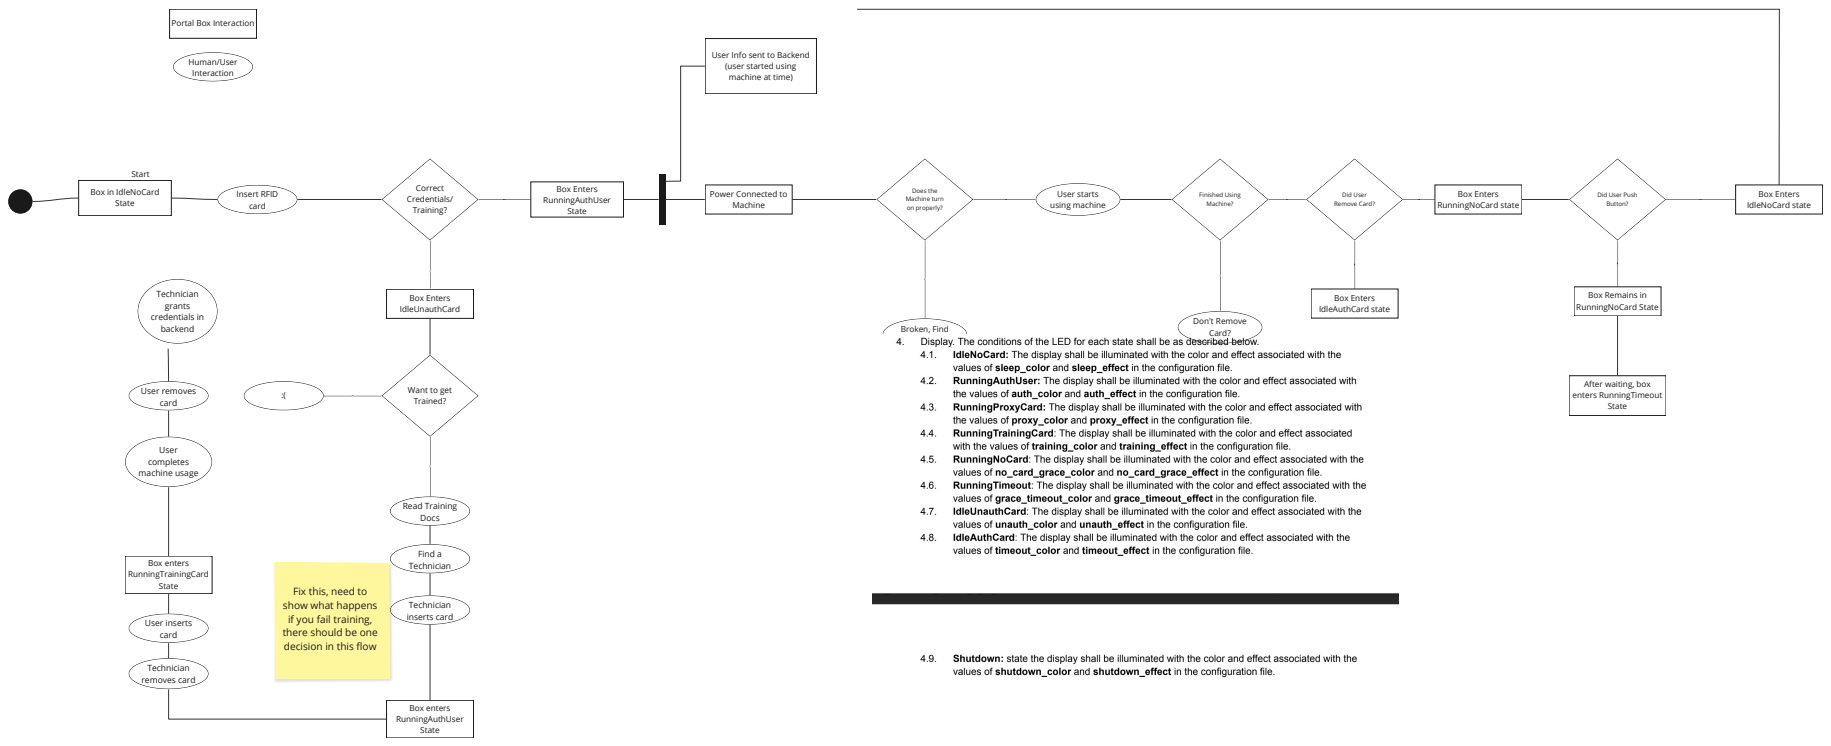
[picture p72: page 1]
Start; Insert RFID card; Correct Credentials/ Training?; Yes; Find a Technician; Technician inserts card; User completes; Technician grants credentials in backend; Finished Using Machine?; Box Enters RunningNoCard state; Yes Box Enters IdleAuthCard state

Portal Box Interaction

User Info sent to Backend (user started using

Human/User Interaction

machine at time)

Box Enters RunningAuthUser State

No Box in IdleNoCard State

Power Connected to Machine Want to get Trained?

Does the Machine turn on properly?
Yes Broken, Find Technician

User starts using machine

Yes Box Remains in RunningNoCard State Don't Remove Card?

Did User Remove Card?

Did User Push Button?

Box Enters IdleNoCard state

No After waiting, box

Box Enters IdleUnauthCard

machine usage User removes card

enters RunningTimeout State

Read Training Docs

removes card User inserts card Box enters RunningTrainingCard State

Fix this, need to
show what happens
if you fail training,
there should be one
decision in this flow

Box enters RunningAuthUser State Technician
