AxelAndrews/DocumentationSD/Diagrams/System Maps/SystemMapV2.pdf

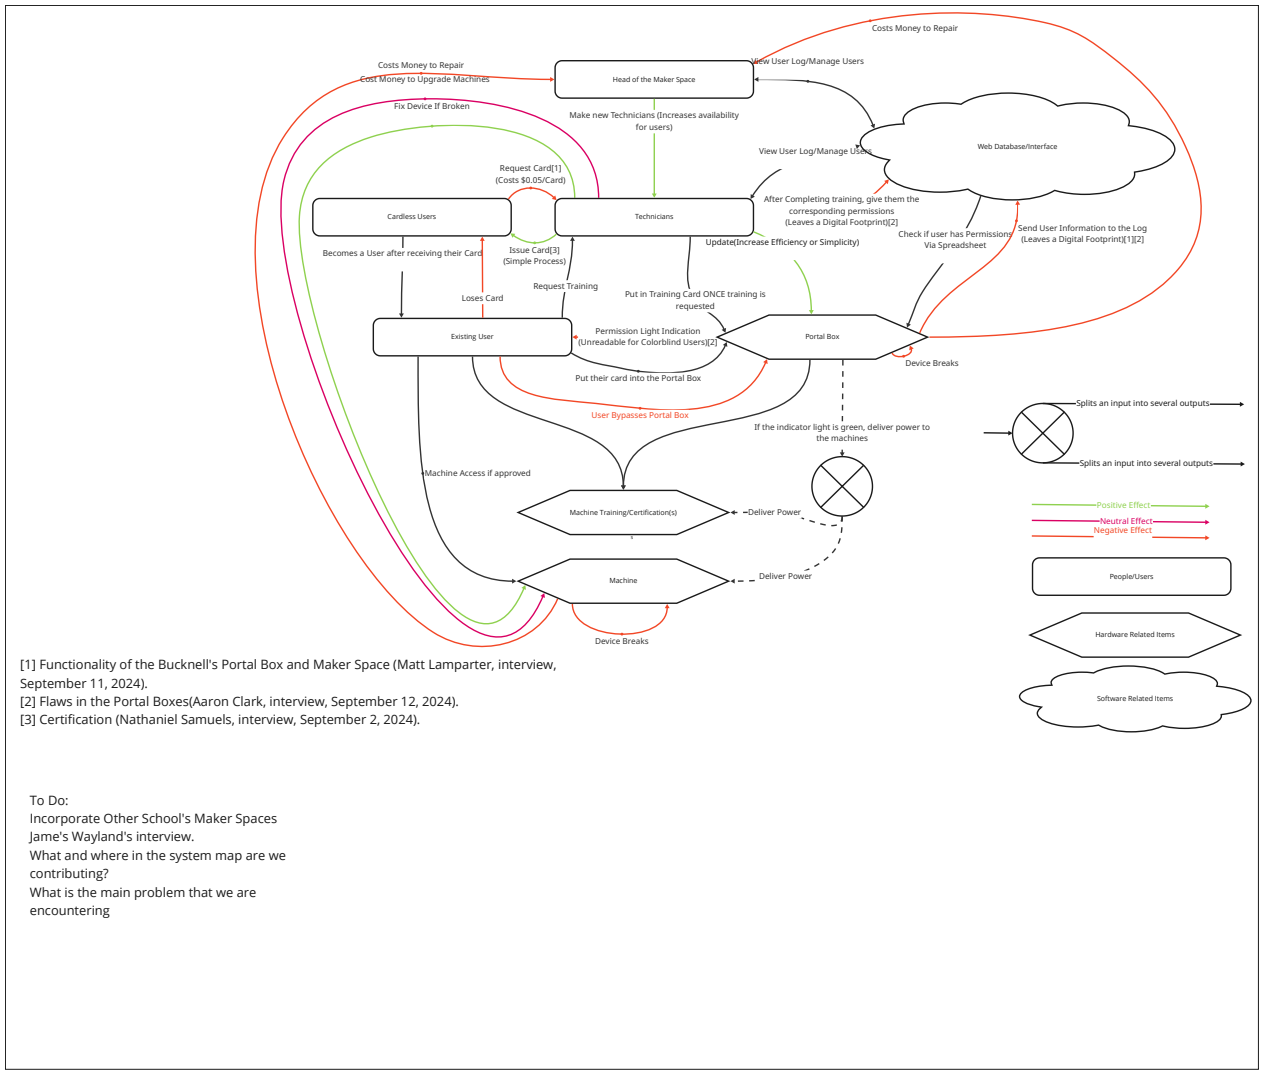
[picture p73: page 1]
Cardless Users; Existing User; Device Breaks; Portal Box; Deliver Power; the machines; Loses Card; Machine; Technicians; Request Training; requested; for users); Request Card[1] (Costs $0.05/Card); Issue Card[3] (Simple Process); People/Users; Negative Effect; Positive Effect Neutral Effect

Costs Money to Repair

Cost Money to Upgrade Machines

View User Log/Manage Users

Head of the Maker Space

Fix Device If Broken

Make new Technicians (Increases availability

Web Database/Interface

After Completing training, give them the
corresponding permissions
(Leaves a Digital Footprint)[2]

Check if user has Permissions
Via Spreadsheet

Send User Information to the Log
(Leaves a Digital Footprint)[1][2]

Update(Increase Efficiency or Simplicity)

Becomes a User after receiving their Card

Put in Training Card ONCE training is

Permission Light Indication
(Unreadable for Colorblind Users)[2]

Put their card into the Portal Box

Splits an input into several outputs

User Bypasses Portal Box

If the indicator light is green, deliver power to

Machine Access if approved

Machine Training/Certification(s)

Hardware Related Items

[1] Functionality of the Bucknell's Portal Box and Maker Space (Matt Lamparter, interview,
September 11, 2024).
[2] Flaws in the Portal Boxes(Aaron Clark, interview, September 12, 2024).
[3] Certification (Nathaniel Samuels, interview, September 2, 2024).

Software Related Items

Incorporate Other School's Maker Spaces
Jame's Wayland's interview.
What and where in the system map are we
contributing?
What is the main problem that we are
encountering
