AxelAndrews/DocumentationSD/Diagrams/System Maps/SystemMapV3.pdf

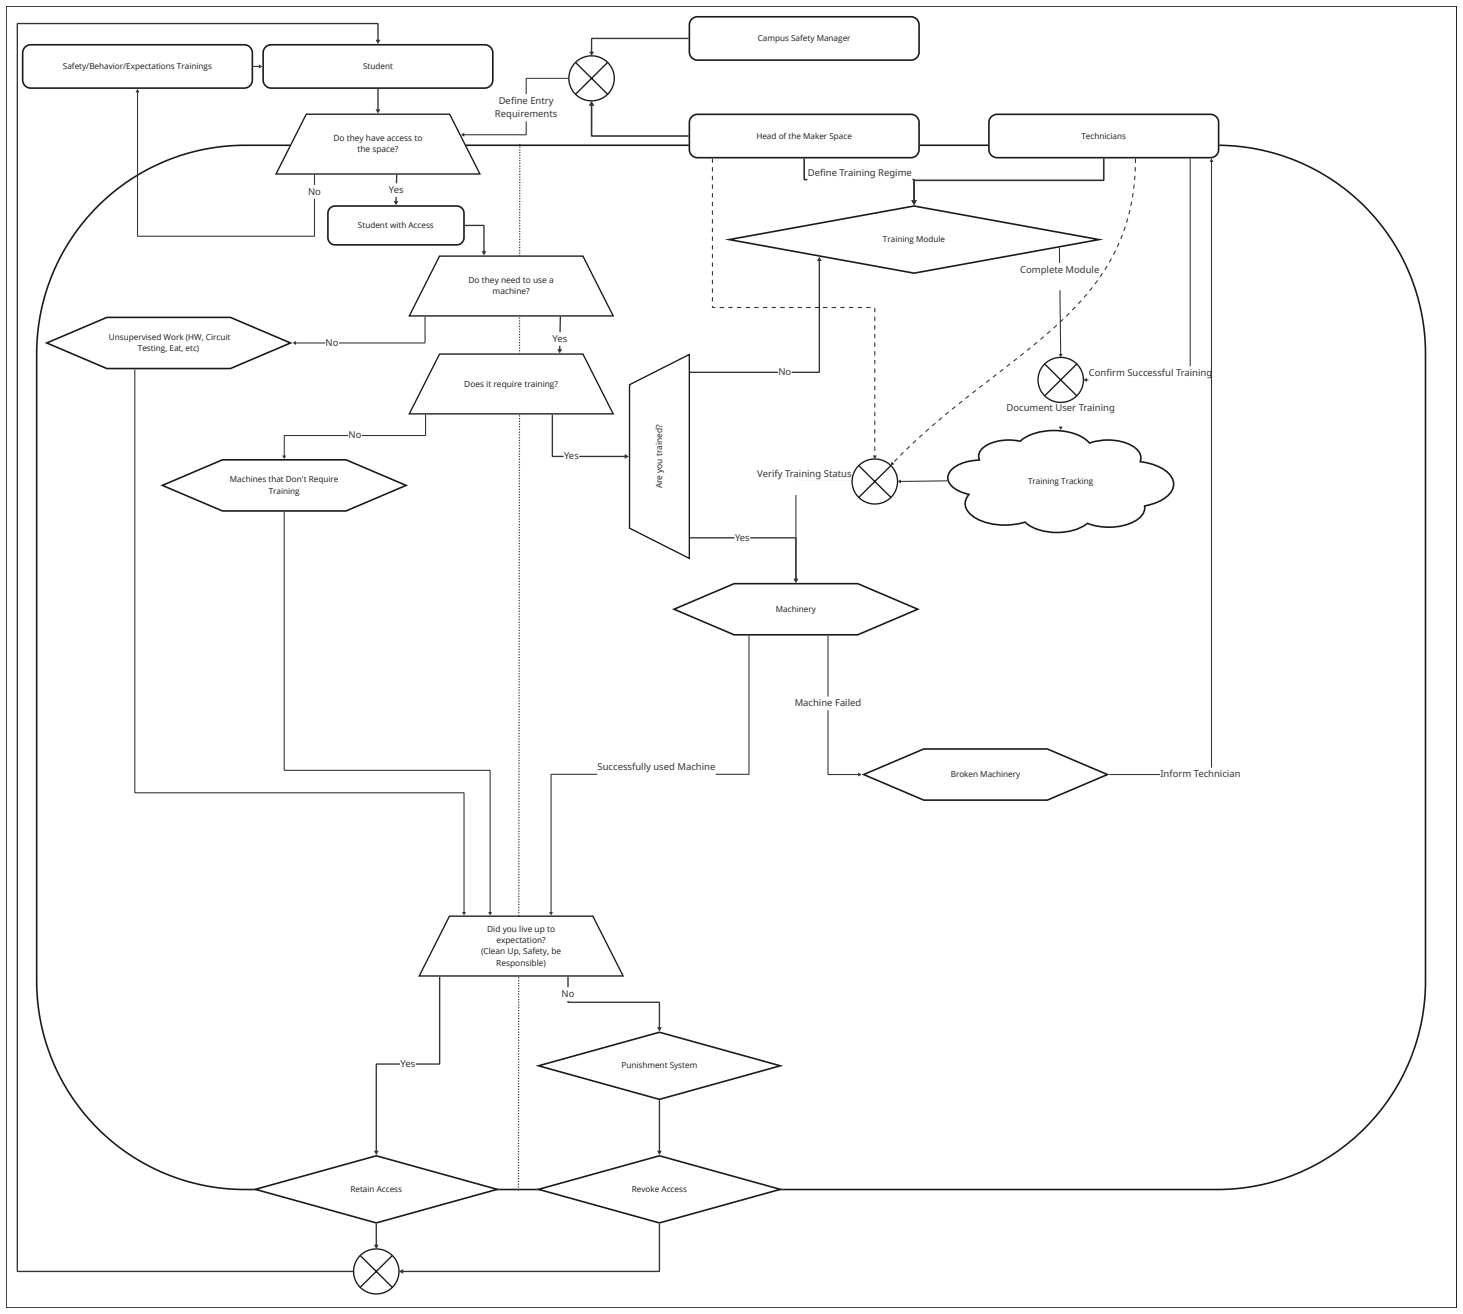
[picture p74: page 1]
Punishment System; Retain Access; Revoke Access; Yes; Training; Machinery; Machine Failed; Training Tracking; Yes No; Training Module; Complete Module; Technicians; Inform Technician; Define Entry Requirements; Student

Campus Safety Manager

Safety/Behavior/Expectations Trainings

Do they have access to
the space?

Head of the Maker Space

Define Training Regime

Student with Access

Do they need to use a
machine?

Unsupervised Work (HW, Circuit
Testing, Eat, etc)

Confirm Successful Training

Does it require training?

Document User Training

Broken Machinery Are you trained? Machines that Don't Require

Verify Training Status

Successfully used Machine

Did you live up to
expectation?
(Clean Up, Safety, be
Responsible)
