AxelAndrews/DocumentationSD/Diagrams/System Maps/SystemMapV4.pdf

# Campus Safety Manager Makerspace Access/Training Flows

# Legend:

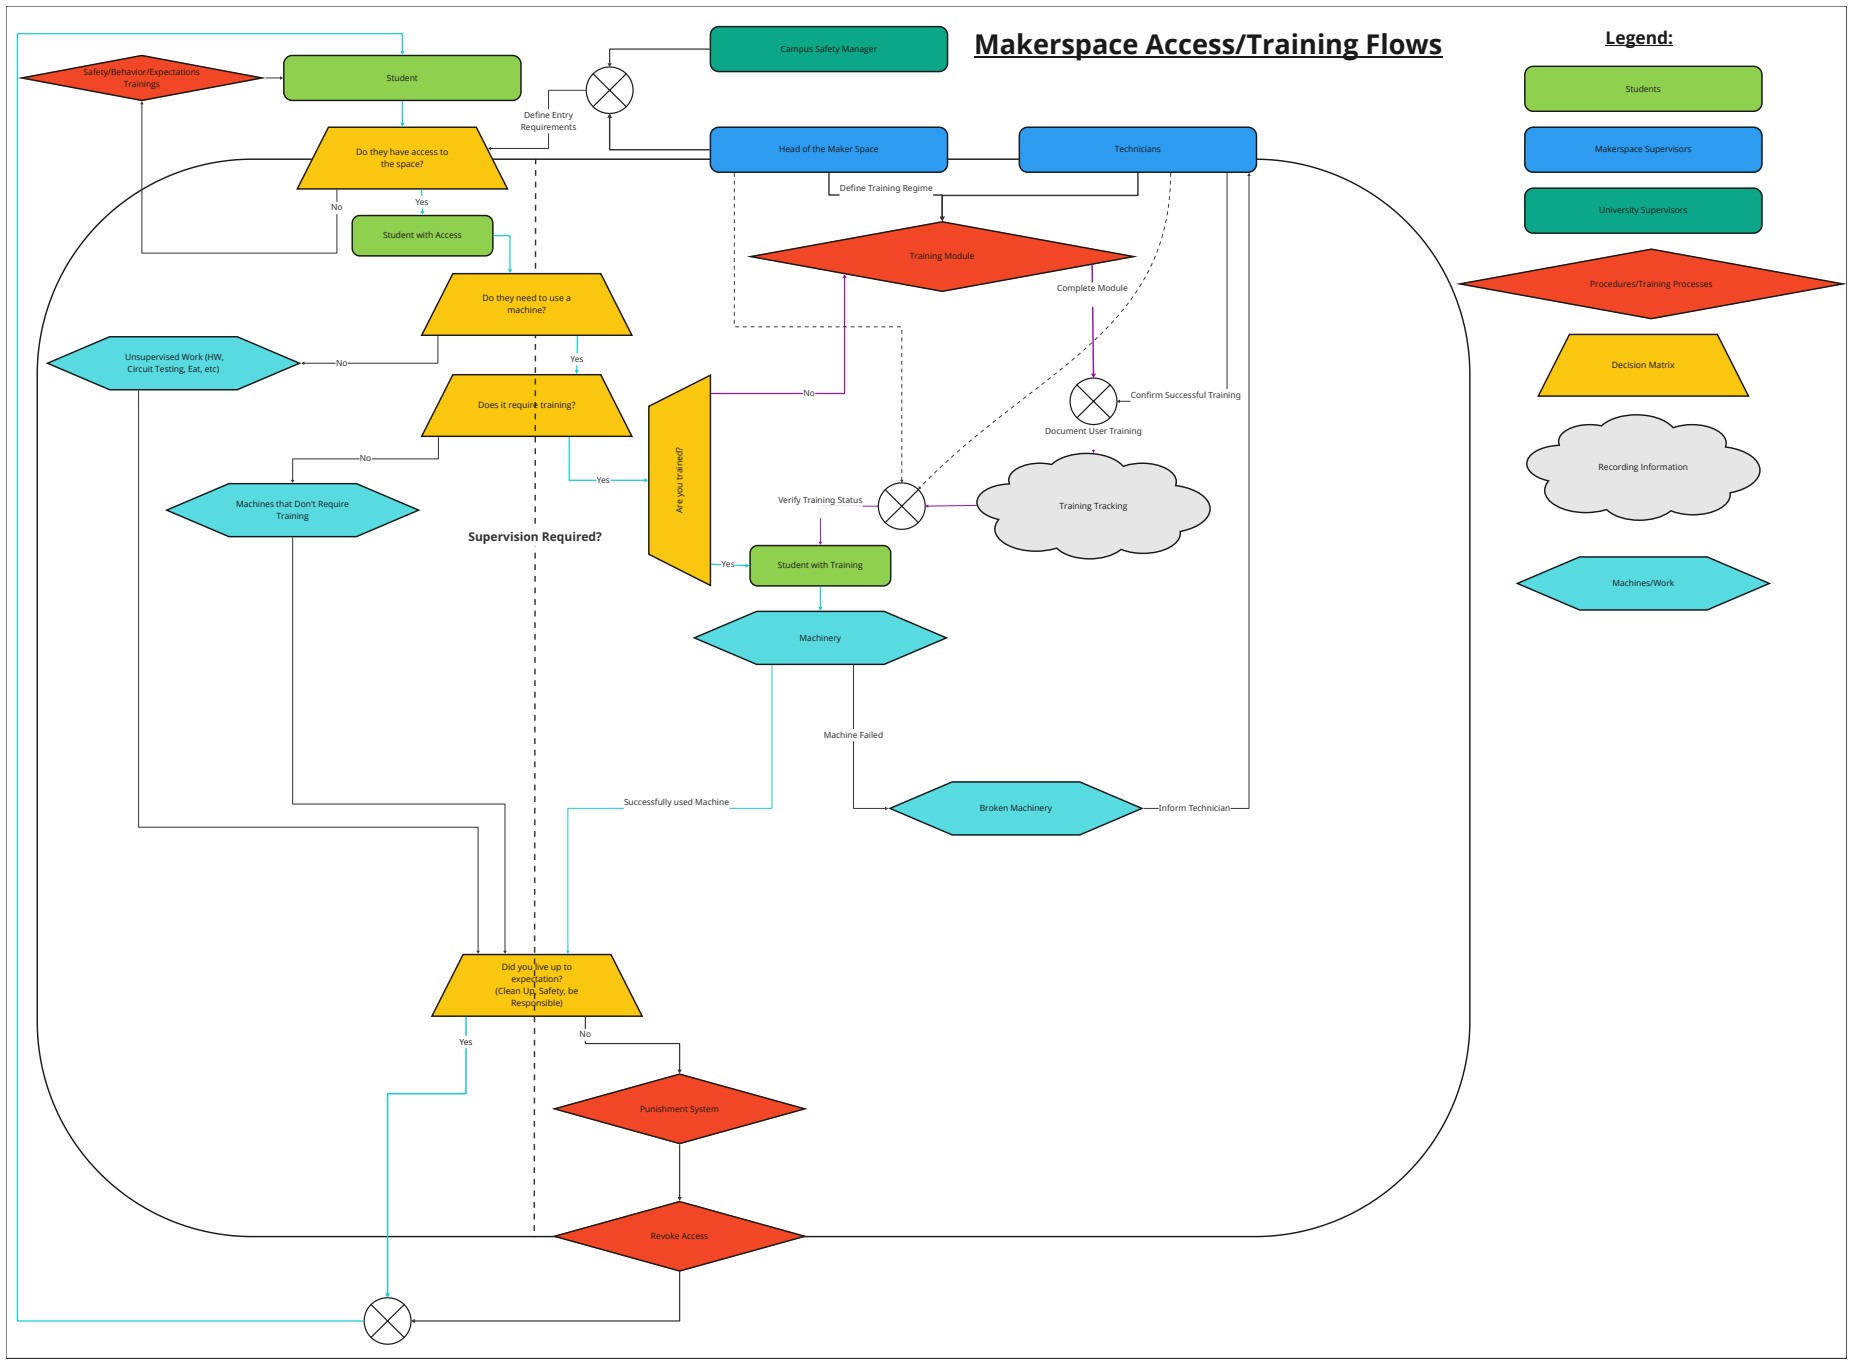
[picture p75: page 1]
Broken Machinery; Machinery; Machine Failed Are you trained?; Training Tracking; Machines/Work; Yes; Student with Training; Revoke Access; Punishment System; Recording Information; Decision Matrix; Supervision Required?; Training Module; Complete Module; Unsupervised Work (HW,; Yes Circuit Testing, Eat, etc); Training; University Supervisors; the space?; Head of the Maker Space; Define Training Regime; Technicians; Inform Technician; Makerspace Supervisors; Define Entry; Requirements; Students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

Safety/Behavior/Expectations

Do they have access to

Student with Access

Procedures/Training Processes

Do they need to use a
machine?

Confirm Successful Training

Does it require training?

Document User Training

Machines that Don't Require

Verify Training Status

Successfully used Machine

Did you live up to
expectation?
(Clean Up, Safety, be
Responsible)
