AxelAndrews/DocumentationSD/Diagrams/System Maps/SystemMapV5.pdf

Community | User

# Director of Space

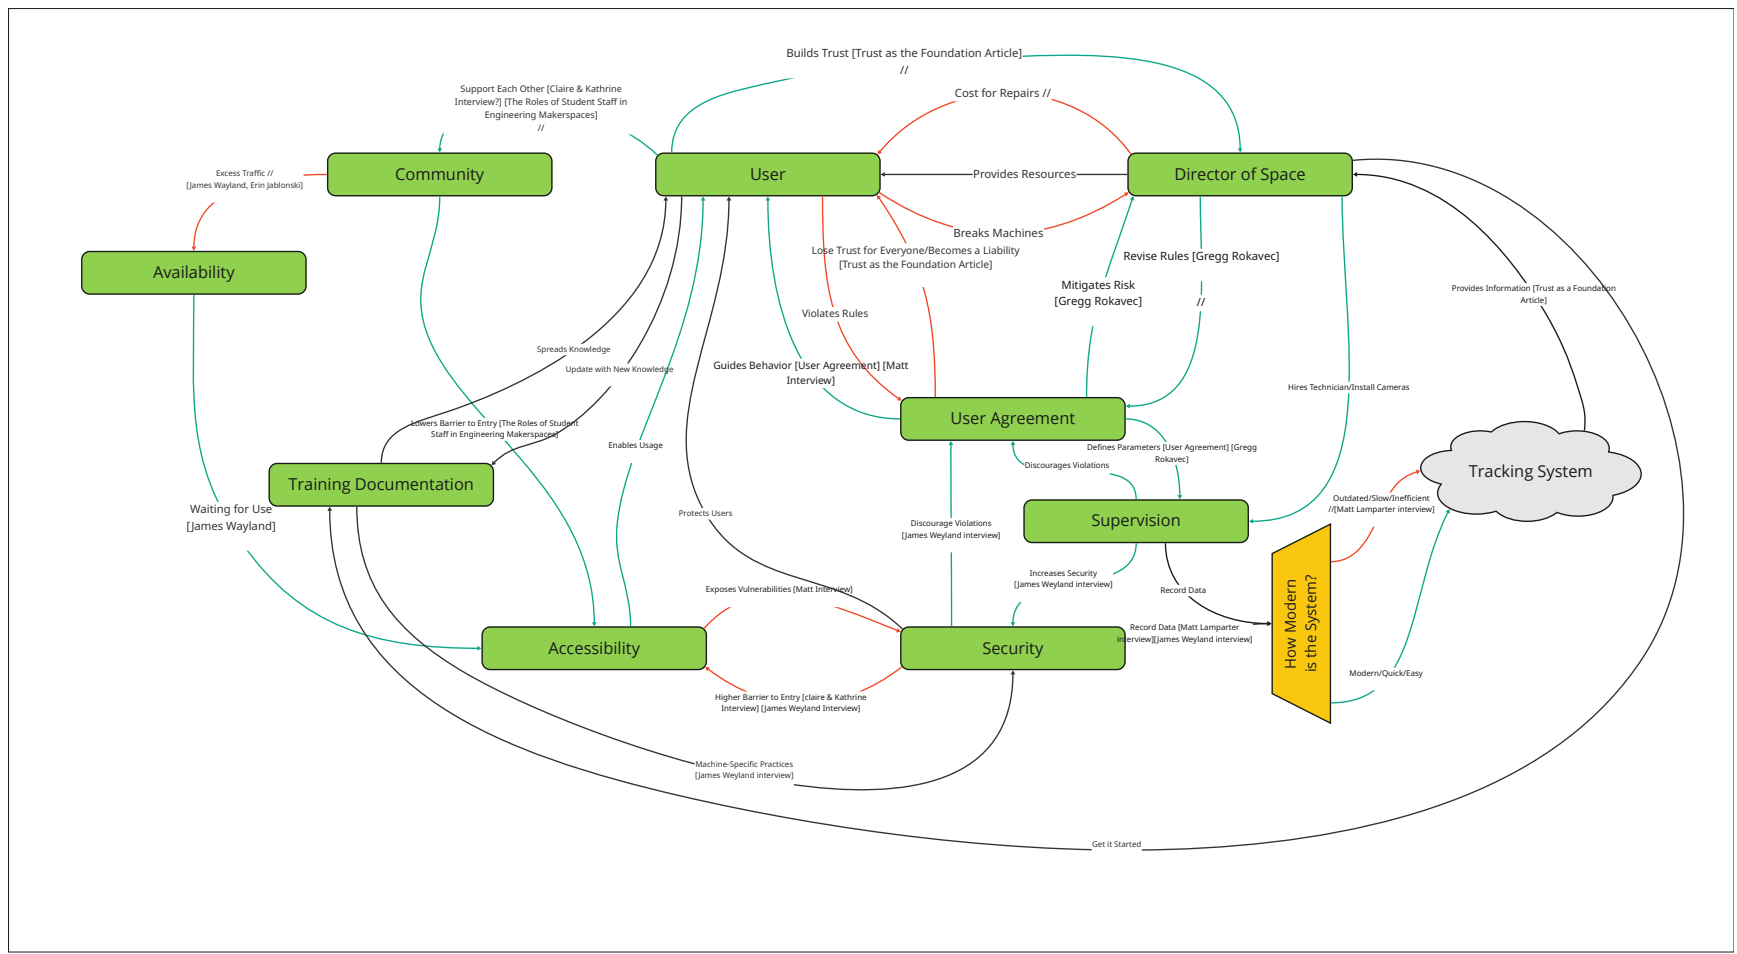
[picture p76: page 1]
User Agreement; Violates Rules; Interview]; Availability; Accessibility; Enables Usage; Training Documentation; Security; Protects Users; Discourage Violations; Supervision; Discourages Violations; Rokavec]; Breaks Machines; Provides Resources; Mitigates Risk [Gregg Rokavec]; Record Data; Tracking System; Article]

Builds Trust [Trust as the Foundation Article]

Support Each Other [Claire & Kathrine
Interview?] [The Roles of Student Staff in
Engineering Makerspaces]

Cost for Repairs //

Excess Traffic //
[James Wayland, Erin Jablonski]

Lose Trust for Everyone/Becomes a Liability
[Trust as the Foundation Article]

Revise Rules [Gregg Rokavec]

Provides Information [Trust as a Foundation

Spreads Knowledge
Update with New Knowledge

Guides Behavior [User Agreement] [Matt

Hires Technician/Install Cameras How Modern is the System? Record Data [Matt Lamparter

Lowers Barrier to Entry [The Roles of Student
Staff in Engineering Makerspaces]

Defines Parameters [User Agreement] [Gregg

Outdated/Slow/Inefficient
//[Matt Lamparter interview]

Waiting for Use
[James Wayland]

[James Weyland interview]

Increases Security

Exposes Vulnerabilities [Matt Interview]

interview][James Weyland interview]

Modern/Quick/Easy

Higher Barrier to Entry [claire & Kathrine
Interview] [James Weyland Interview]

Machine-Specific Practices

Get it Started
