AxelAndrews/DocumentationSD/Diagrams/System Maps/SystemMapV6.pdf

# Director of Space

# Community

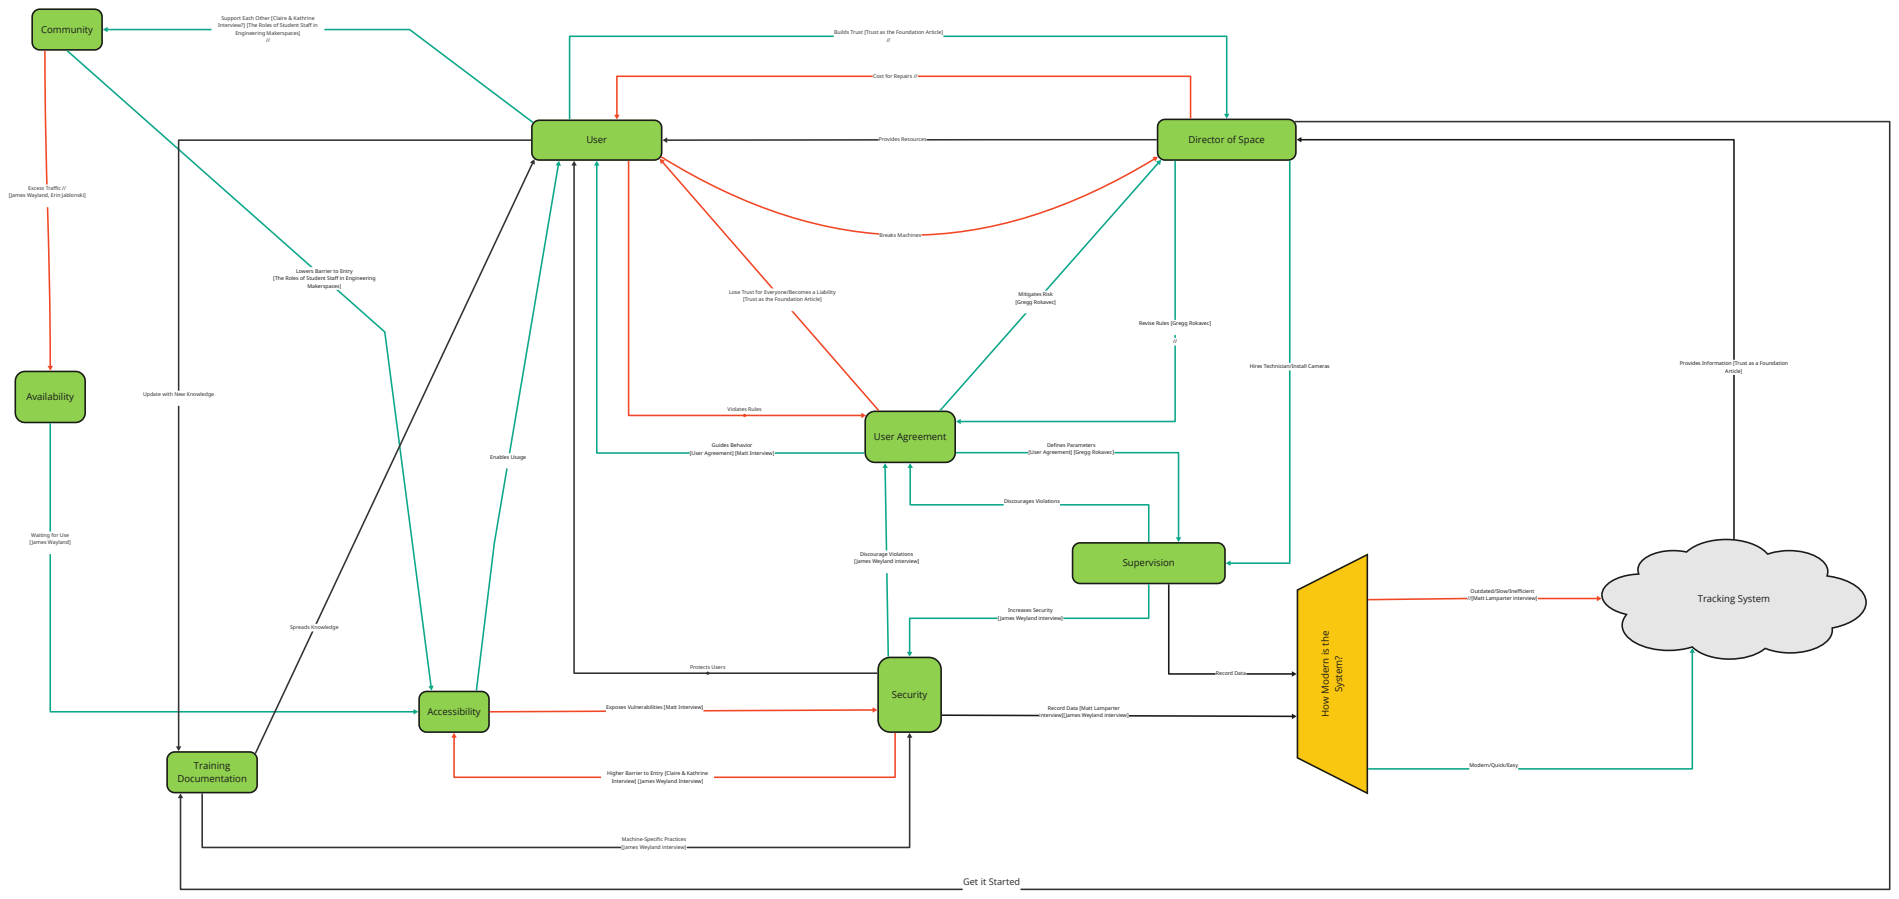
[picture p77: page 1]
Supervision; Mitigates Risk [Gregg Rokavec]; Discourages Violations; Defines Parameters; Accessibility; Training Documentation; Get it Started; How Modern is the System? Record Data Security; Increases Security; [James Weyland interview]; Tracking System; User; Breaks Machines; Provides Resources; Violates Rules; Guides Behavior; Enables Usage; Spreads Knowledge; Protects Users

Support Each Other [Claire & Kathrine
Interview?] [The Roles of Student Staff in
Engineering Makerspaces]

Builds Trust [Trust as the Foundation Article]

Cost for Repairs //

Excess Traffic //
[James Wayland, Erin Jablonski]

[The Roles of Student Staff in Engineering Makerspaces]

Lowers Barrier to Entry

Lose Trust for Everyone/Becomes a Liability
[Trust as the Foundation Article]

Revise Rules [Gregg Rokavec]

Hires Technician/Install Cameras User Agreement

Provides Information [Trust as a Foundation Article]

[User Agreement] [Gregg Rokavec] Availability

Update with New Knowledge

[User Agreement] [Matt Interview]

Waiting for Use
[James Wayland]

Discourage Violations
[James Weyland interview]

Outdated/Slow/Inefficient
//[Matt Lamparter interview]

Exposes Vulnerabilities [Matt Interview]

Record Data [Matt Lamparter
interview][James Weyland interview]

Higher Barrier to Entry [Claire & Kathrine
Interview] [James Weyland Interview]

Modern/Quick/Easy

Machine-Specific Practices
