AxelAndrews/DocumentationSD/Fabrication Files/PCB/V4.1/Portal Box 4.1 03-07-25.kicad_pcb

## KiCad design Fabrication Files/PCB/V4.1/Portal Box 4.1 03-07-25.kicad_pcb (2025-05-12, an earlier design)

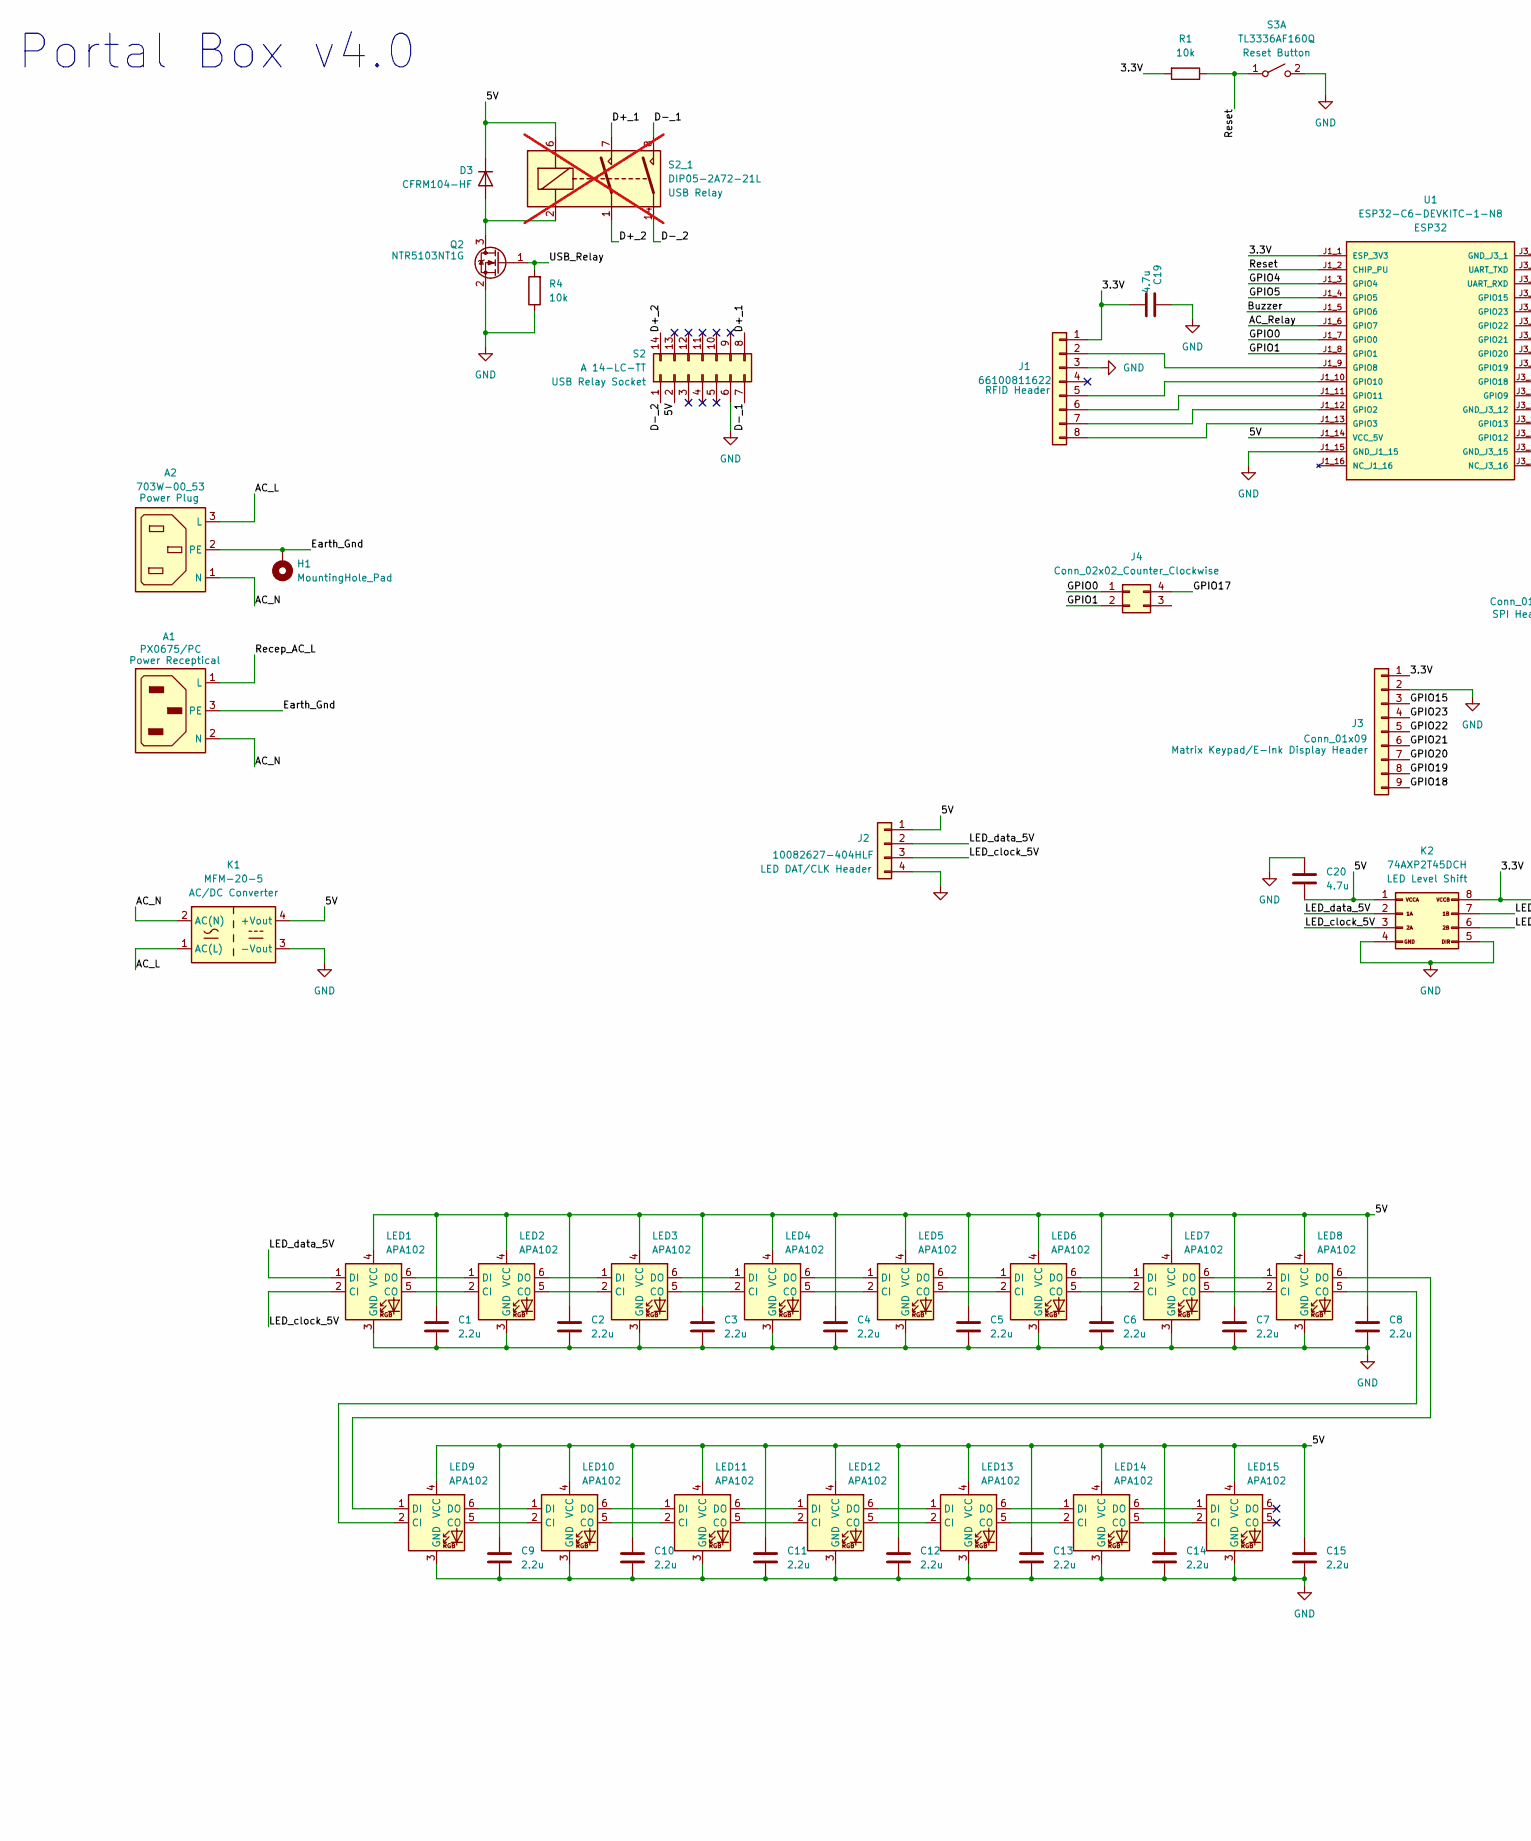
[picture p78: schematic Portal Box 4.1 03-07-25.kicad_sch, part in row 1, column 1]

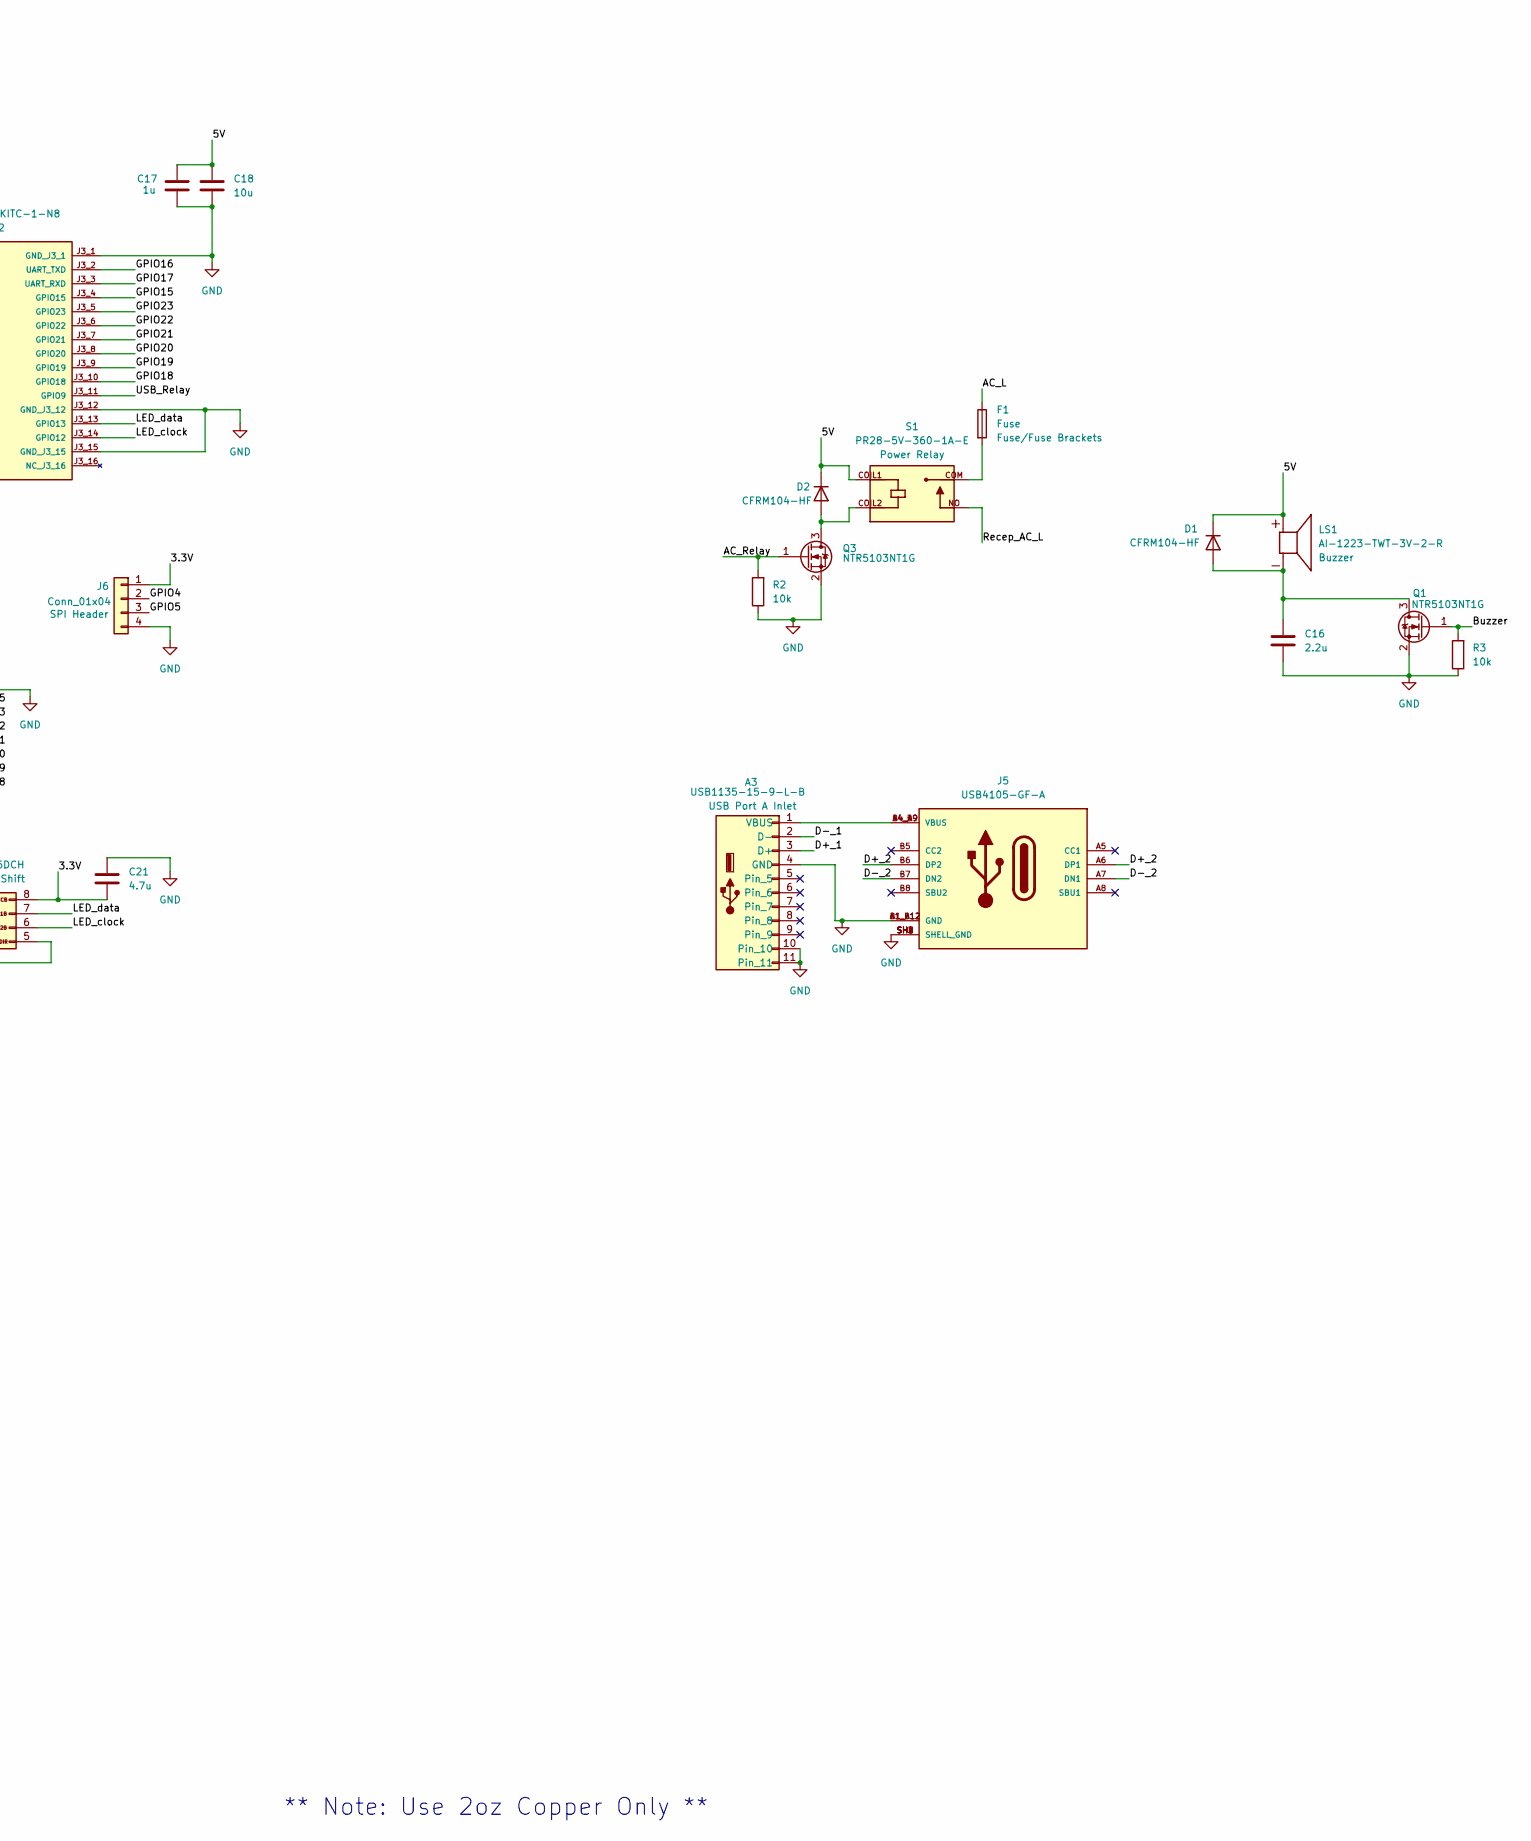
[picture p79: schematic Portal Box 4.1 03-07-25.kicad_sch, part in row 1, column 2]

Parts:
A1: PX0675/PC; BULGIN_PX0675_PC
A2: 703W-00_53; QUALTEK_703W-00_53
A3: USB1135-15-9-L-B; GCT_USB1135-15-9-L-B_REVA1
C1, C2, C3, C4, C5, C6, C7, C8, C9, C10, C11, C12, C13, C14, C15, C16: 2.2u; C_0805_2012Metric
C17: 1u; C_0805_2012Metric
C18: 10u; C_0805_2012Metric
C19, C20, C21: 4.7u; C_0805_2012Metric
D1, D2, D3: CFRM104-HF; D_SOD-123
F1: Fuse; Fuseholder_Clip-5x20mm_Schurter_CQM_Inline_P20.60x5.00mm_D1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
H1: MountingHole_Pad; MountingHole_3.2mm_M3
J1: 66100811622; PinHeader_1x08_P2.54mm_Vertical
J2: 10082627-404HLF; PinHeader_1x04_P2.54mm_Vertical
J3: Conn_01x09; PinHeader_1x09_P2.54mm_Vertical
J4: Conn_02x02_Counter_Clockwise; PinHeader_2x02_P2.54mm_Vertical
J5: USB4105-GF-A; GCT_USB4105-GF-A; PARTREV B4
J6: Conn_01x04; PinHeader_1x04_P2.54mm_Vertical
K1: MFM-20-5; Converter_ACDC_MeanWell_MFM-15-xx_THT
K2: 74AXP2T45DCH; VSSOP8_SOT765-1_NEX
LED1, LED2, LED3, LED4, LED5, LED6, LED7, LED8, LED9, LED10, LED11, LED12, LED13, LED14, LED15: APA102; SK9822_ADA
LS1: AI-1223-TWT-3V-2-R; XDCR_AI-1223-TWT-3V-2-R; PARTREV 3/18/2020; DigiKey_Part_Number 668-1456-ND
Q1, Q2, Q3: NTR5103NT1G; SOT-23
R1, R2, R3, R4: 10k; R_0805_2012Metric
S1: PR28-5V-360-1A-E; RELAY_PR28-5V-360-1A-E; PARTREV 1.01
S2: A 14-LC-TT; DIP-14_W7.62mm
S2_1: DIP05-2A72-21L; Relay_StandexMeder_DIP_LowProfile; not fitted
S3: TL3336AF160Q; SW_TL3336AF160Q
U1: ESP32-C6-DEVKITC-1-N8; MODULE_ESP32-C6-DEVKITC-1-N8; PARTREV 1.3

Connections:
/3.3V: C19.2, C21.2, J1.1, J3.1, J6.1, K2.8 (VCCB), R1.2, U1.J1_1 (ESP_3V3)
/5V: C1.1, C2.1, C3.1, C4.1, C5.1, C6.1, C7.1, C8.1, C9.1, C10.1, C11.1, C12.1, C13.1, C14.1, C15.1, C17.1, C18.1, C20.2, D1.1 (K), D2.1 (K), D3.1 (K), J2.1, K1.4 (+Vout), K2.1 (VCCA), LED1.4 (VCC), LED2.4 (VCC), LED3.4 (VCC), LED4.4 (VCC), LED5.4 (VCC), LED6.4 (VCC), LED7.4 (VCC), LED8.4 (VCC), LED9.4 (VCC), LED10.4 (VCC), LED11.4 (VCC), LED12.4 (VCC), LED13.4 (VCC), LED14.4 (VCC), LED15.4 (VCC), LS1.P, S1.COIL1, S2.2, S2_1.6, U1.J1_14 (VCC_5V)
/AC_L: A2.3 (L), F1.1, K1.1 (AC(L))
/AC_N: A1.2 (N), A2.1 (N), K1.2 (AC(N))
/AC_Relay: Q3.1 (G), R2.2, U1.J1_6 (GPIO7)
/Buzzer: Q1.1 (G), R3.2, U1.J1_5 (GPIO6)
/D+_1: A3.3 (D+), S2.8, S2_1.7
/D+_2: J5.A6 (DP1), J5.B6 (DP2), S2.14, S2_1.1
/D-_1: A3.2 (D-), S2.7, S2_1.8
/D-_2: J5.A7 (DN1), J5.B7 (DN2), S2.1, S2_1.14
/Earth_Gnd: A1.3 (PE), A2.2 (PE), H1.1
/GPIO0: J4.1, U1.J1_7 (GPIO0)
/GPIO1: J4.2, U1.J1_8 (GPIO1)
/GPIO4: J6.2, U1.J1_3 (GPIO4)
/GPIO5: J6.3, U1.J1_4 (GPIO5)
/GPIO15: J3.3, U1.J3_4 (GPIO15)
/GPIO16: U1.J3_2 (UART_TXD)
/GPIO17: J4.4, U1.J3_3 (UART_RXD)
/GPIO18: J3.9, U1.J3_10 (GPIO18)
/GPIO19: J3.8, U1.J3_9 (GPIO19)
/GPIO20: J3.7, U1.J3_8 (GPIO20)
/GPIO21: J3.6, U1.J3_7 (GPIO21)
/GPIO22: J3.5, U1.J3_6 (GPIO22)
/GPIO23: J3.4, U1.J3_5 (GPIO23)
/LED_clock: K2.6 (2B), U1.J3_14 (GPIO12)
/LED_clock_5V: J2.3, K2.3 (2B), LED1.2 (CI)
/LED_data: K2.7 (1B), U1.J3_13 (GPIO13)
/LED_data_5V: J2.2, K2.2 (1A), LED1.1 (DI)
/Recep_AC_L: A1.1 (L), S1.NO
/Reset: R1.1, S3.1 (A), U1.J1_2 (CHIP_PU)
/USB_Relay: Q2.1 (G), R4.2, U1.J3_11 (GPIO9)
GND: A3.4 (GND), A3.10, A3.11, C1.2, C2.2, C3.2, C4.2, C5.2, C6.2, C7.2, C8.2, C9.2, C10.2, C11.2, C12.2, C13.2, C14.2, C15.2, C16.2, C17.2, C18.2, C19.1, C20.1, C21.1, J1.3, J2.4, J3.2, J5.A1_B12 (GND), J5.B1_A12 (GND), J5.SH1 (SHELL_GND), J5.SH2 (SHELL_GND), J5.SH3 (SHELL_GND), J5.SH4 (SHELL_GND), J6.4, K1.3 (-Vout), K2.4 (GND), K2.5 (DIR), LED1.3 (GND), LED2.3 (GND), LED3.3 (GND), LED4.3 (GND), LED5.3 (GND), LED6.3 (GND), LED7.3 (GND), LED8.3 (GND), LED9.3 (GND), LED10.3 (GND), LED11.3 (GND), LED12.3 (GND), LED13.3 (GND), LED14.3 (GND), LED15.3 (GND), Q1.2 (S), Q2.2 (S), Q3.2 (S), R2.1, R3.1, R4.1, S2.6, S3.2 (B), U1.J1_15 (GND_J1_15), U1.J3_1 (GND_J3_1), U1.J3_12 (GND_J3_12), U1.J3_15 (GND_J3_15)
unnamed: A3.1 (VBUS), J5.A4_B9 (VBUS), J5.B4_A9 (VBUS)
unnamed: C16.1, D1.2 (A), LS1.N, Q1.3 (D)
unnamed: D2.2 (A), Q3.3 (D), S1.COIL2
unnamed: D3.2 (A), Q2.3 (D), S2_1.2
unnamed: F1.2, S1.COM
unnamed: J1.2, U1.J1_9 (GPIO8)
unnamed: J1.5, U1.J1_10 (GPIO10)
unnamed: J1.6, U1.J1_11 (GPIO11)
unnamed: J1.7, U1.J1_12 (GPIO2)
unnamed: J1.8, U1.J1_13 (GPIO3)
unnamed: LED1.5 (CO), LED2.2 (CI)
unnamed: LED1.6 (DO), LED2.1 (DI)
unnamed: LED2.5 (CO), LED3.2 (CI)
unnamed: LED2.6 (DO), LED3.1 (DI)
unnamed: LED3.5 (CO), LED4.2 (CI)
unnamed: LED3.6 (DO), LED4.1 (DI)
unnamed: LED4.5 (CO), LED5.2 (CI)
unnamed: LED4.6 (DO), LED5.1 (DI)
unnamed: LED5.5 (CO), LED6.2 (CI)
unnamed: LED5.6 (DO), LED6.1 (DI)
unnamed: LED6.5 (CO), LED7.2 (CI)
unnamed: LED6.6 (DO), LED7.1 (DI)
unnamed: LED7.5 (CO), LED8.2 (CI)
unnamed: LED7.6 (DO), LED8.1 (DI)
unnamed: LED8.5 (CO), LED9.2 (CI)
unnamed: LED8.6 (DO), LED9.1 (DI)
unnamed: LED9.5 (CO), LED10.2 (CI)
unnamed: LED10.5 (CO), LED11.2 (CI)
unnamed: LED9.6 (DO), LED10.1 (DI)
unnamed: LED10.6 (DO), LED11.1 (DI)
unnamed: LED11.5 (CO), LED12.2 (CI)
unnamed: LED11.6 (DO), LED12.1 (DI)
unnamed: LED12.5 (CO), LED13.2 (CI)
unnamed: LED12.6 (DO), LED13.1 (DI)
unnamed: LED13.5 (CO), LED14.2 (CI)
unnamed: LED13.6 (DO), LED14.1 (DI)
unnamed: LED14.5 (CO), LED15.2 (CI)
unnamed: LED14.6 (DO), LED15.1 (DI)

Notes on the sheet:
** Note: Use 2oz Copper Only **
Portal Box v4.0

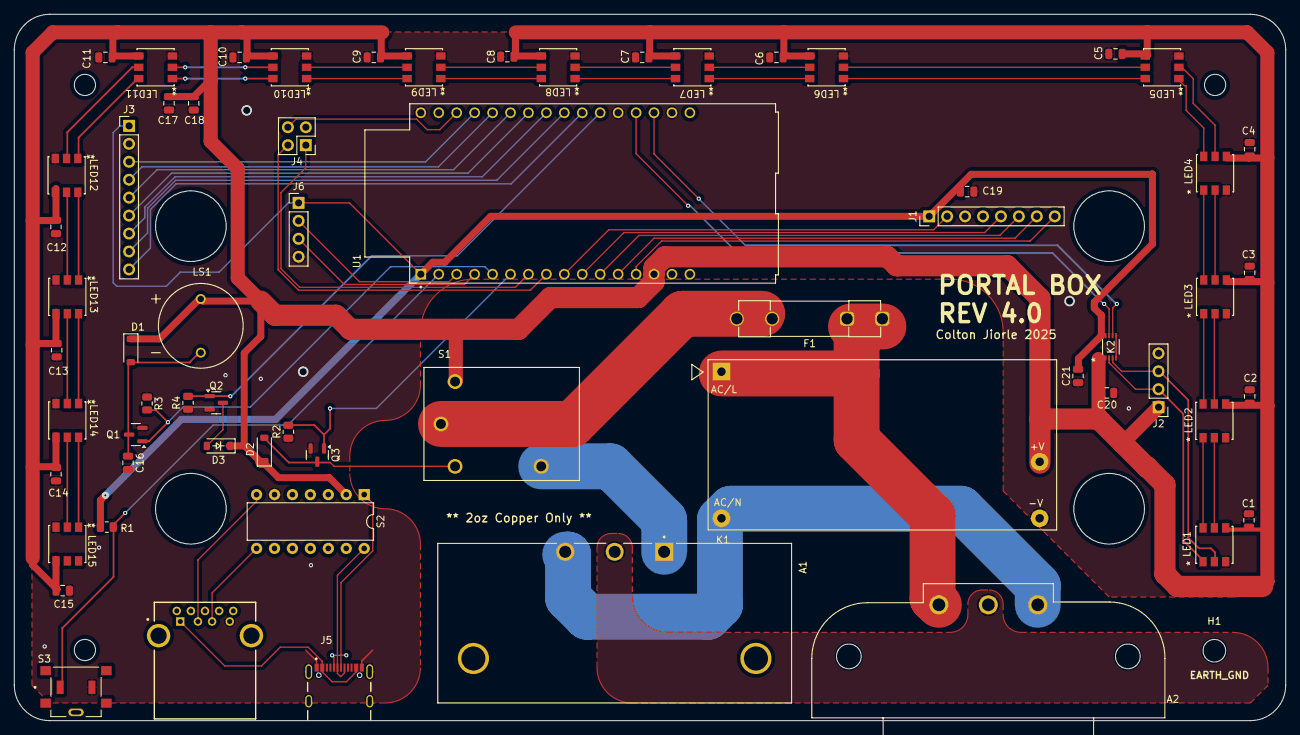
[picture p80: board Portal Box 4.1 03-07-25.kicad_pcb from above]

Board: 2 copper layers, 180.0 x 100.0 mm, 64 parts (0 on the bottom side), 69 nets.
